GitWorz/logic-noise-synth/bom/Composants_tinkercad.csv

Nom | Quantité | Composant
U1 | 1 | Arduino Uno R3
Board 1 | 1 | Platine d'expérimentation
Board 2 | 1 | Petite platine d'expérimentation
C2 | 1 | 33uF, 50V Condensateur polarisé
D1, D2, D7, D8, D10, D11 | 6 | Jaune LED
Rpot2, Rpot3, Rpot4, Rpot5 | 4 | Potentiomètre
C3, C6, C7 | 3 | Condensateur polarisé
U3 | 1 | Schmitt d'inversion
D3, D4 | 2 | Rouge LED
D5 | 1 | Vert LED
D6, D9 | 2 | Bleu LED
U4 | 1 | Registre de décalage 8 bits
U2 | 1 | Amplificateur opérationnel 741
C4, C5 | 2 | Condensateur polarisé
PIEZO1 | 1 | Buzzer piézoélectrique
R1, R2, R3 | 3 | 1 kΩ Résistance
