GitWorz/logic-noise-synth/media/tinkercad/tinkercad_schematic.pdf

A

1 | 2 | 3 | 4 | 5 | 6

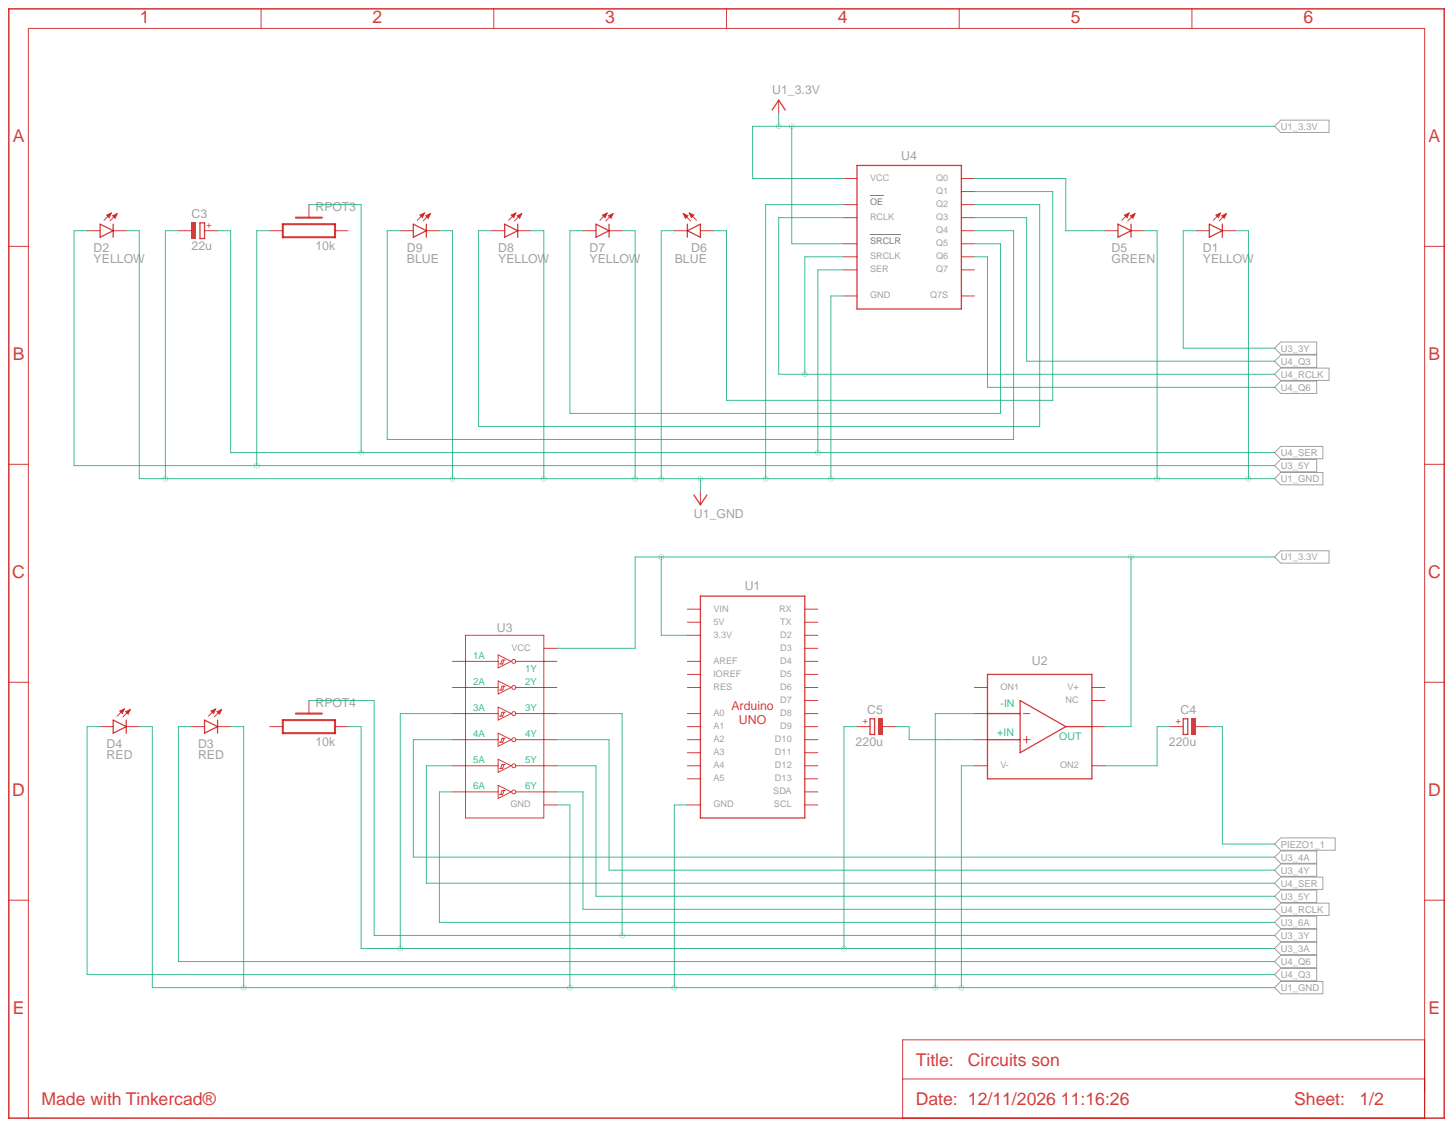
[picture p13: page 1]

A

1 | 2 | 3 | 4 | 5 | 6

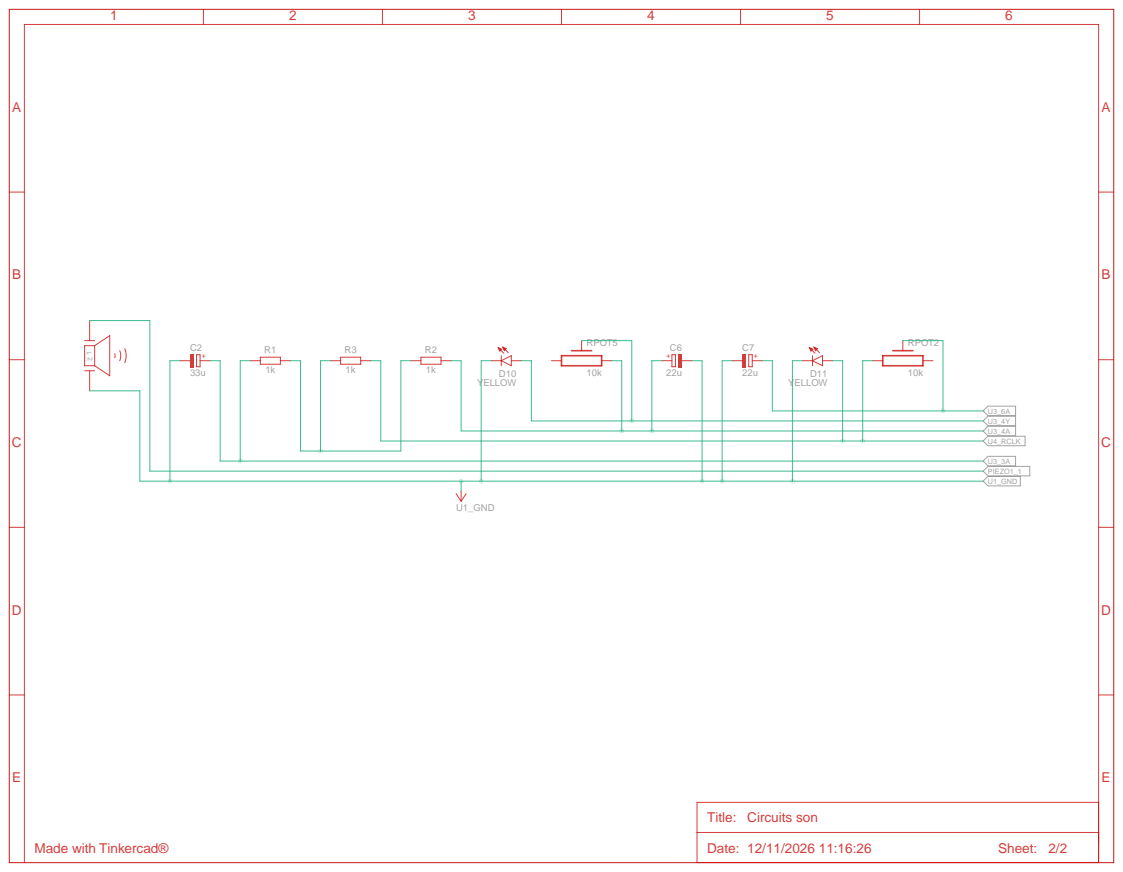
[picture p14: page 2]
