GitWorz/logic-noise-synth/docs/BOOTCAMP_WORKSHOP_2024.pdf

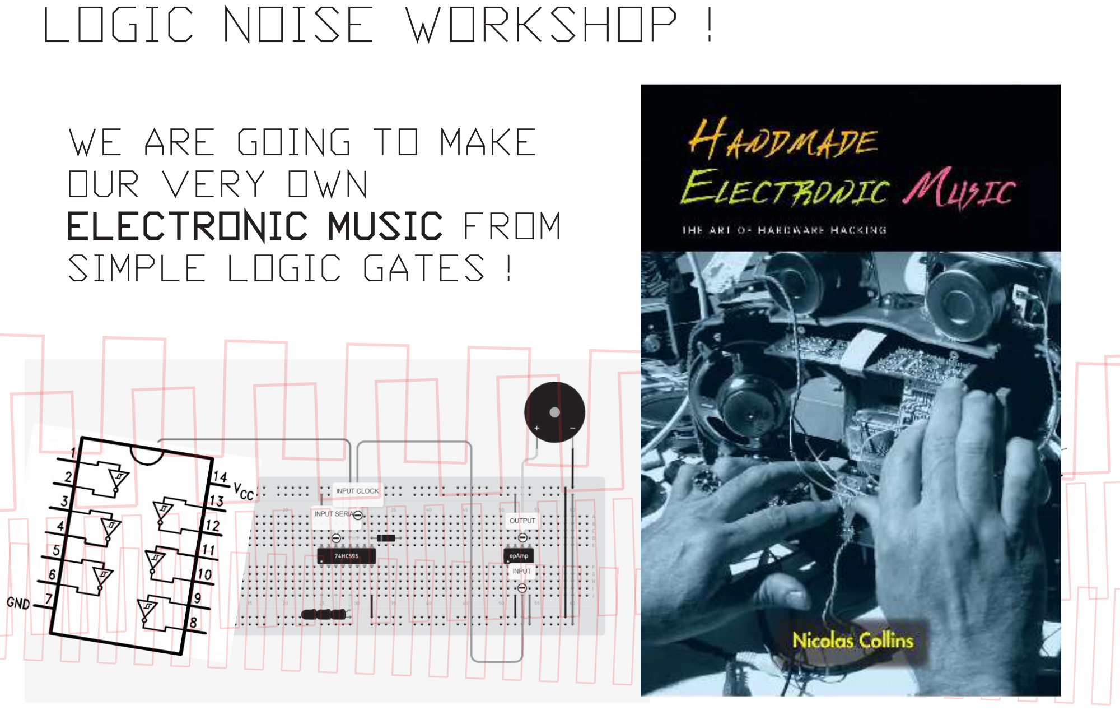
[picture p15: page 1]

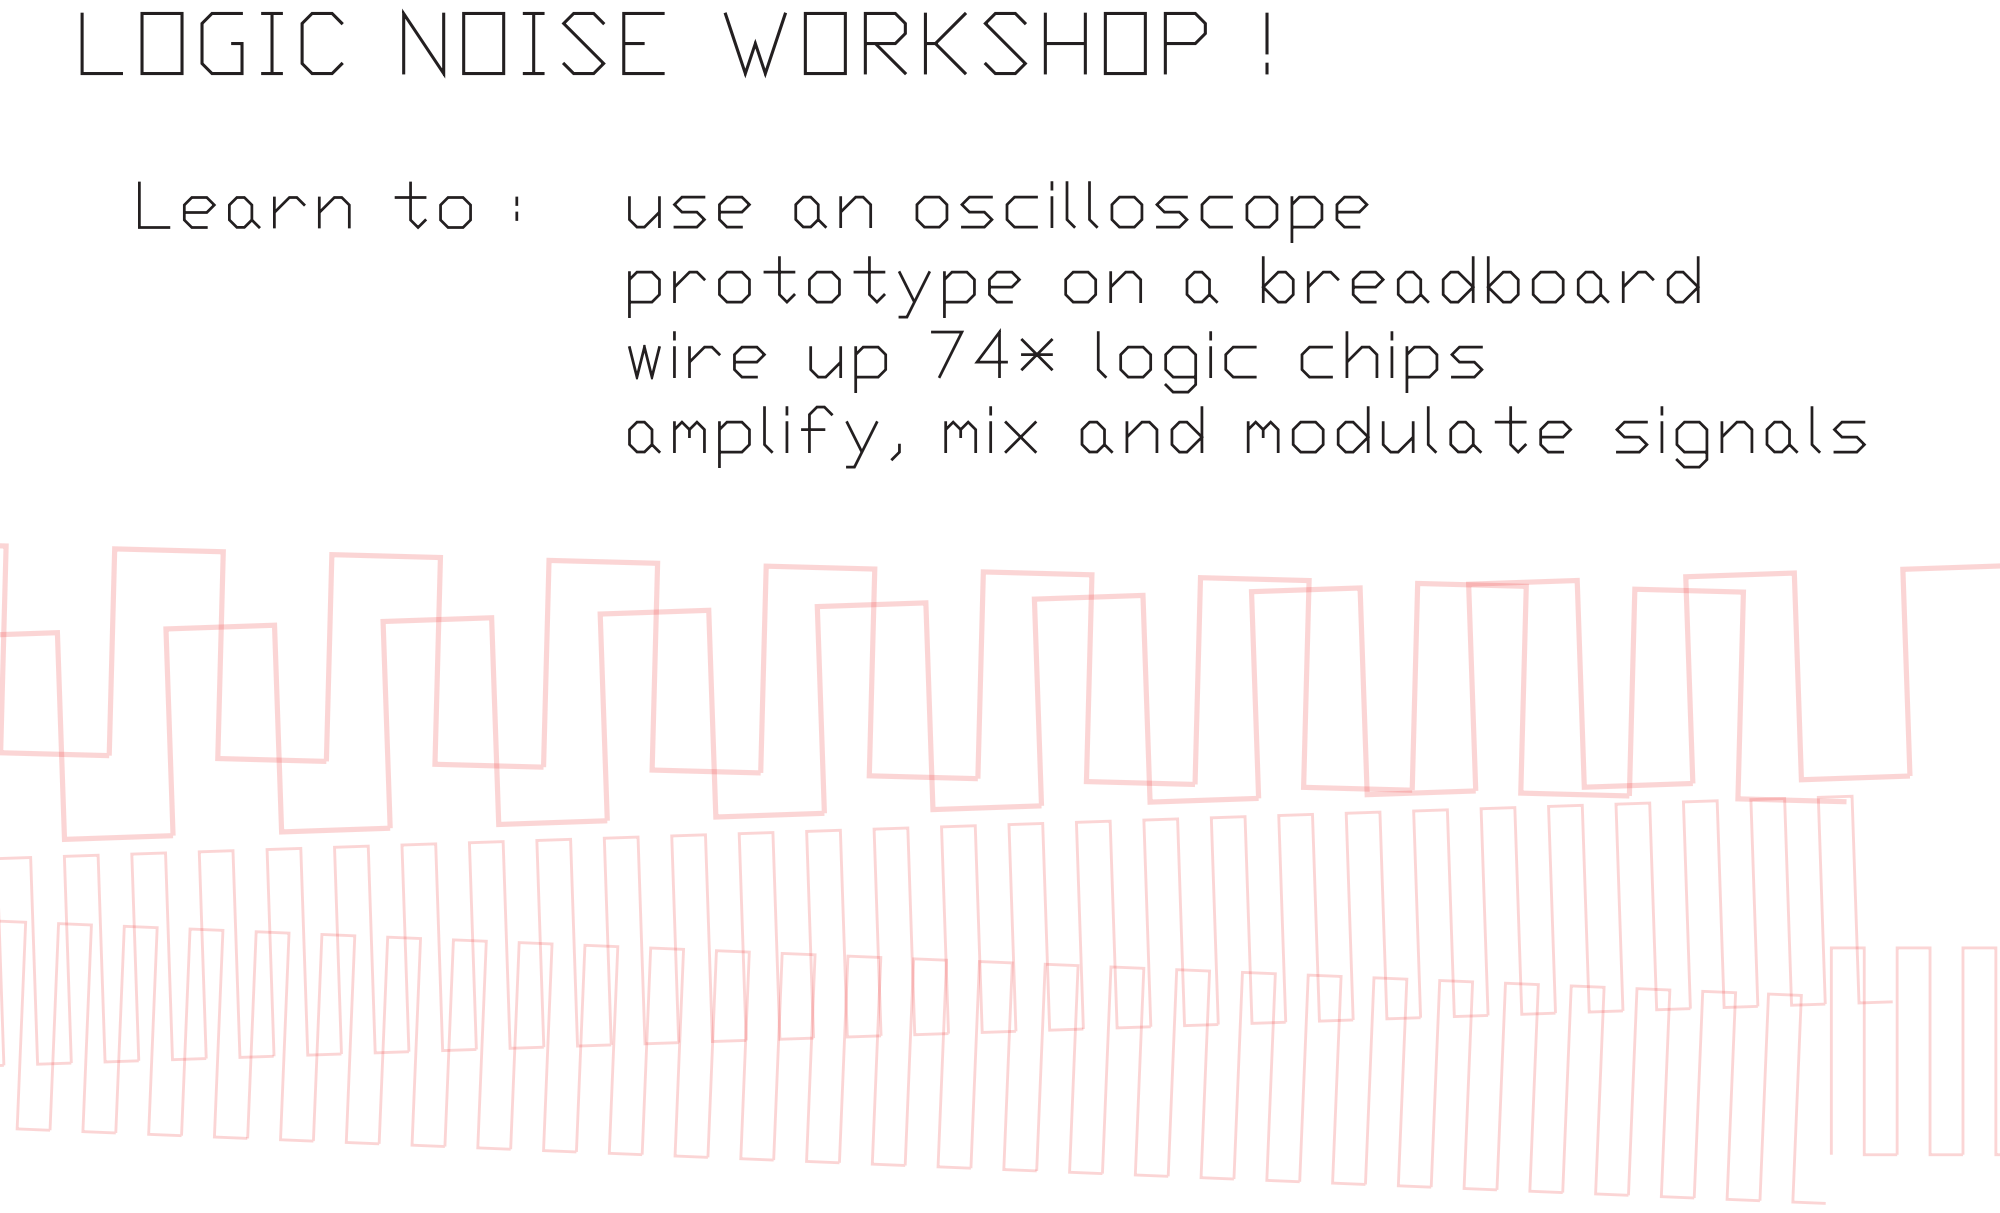
[picture p16: page 2]

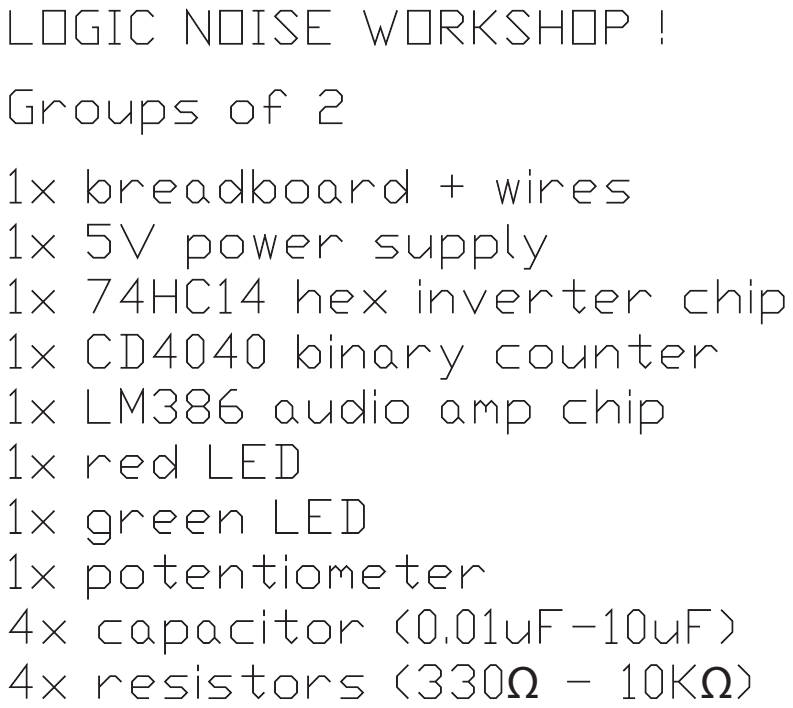
[picture p17: page 3]

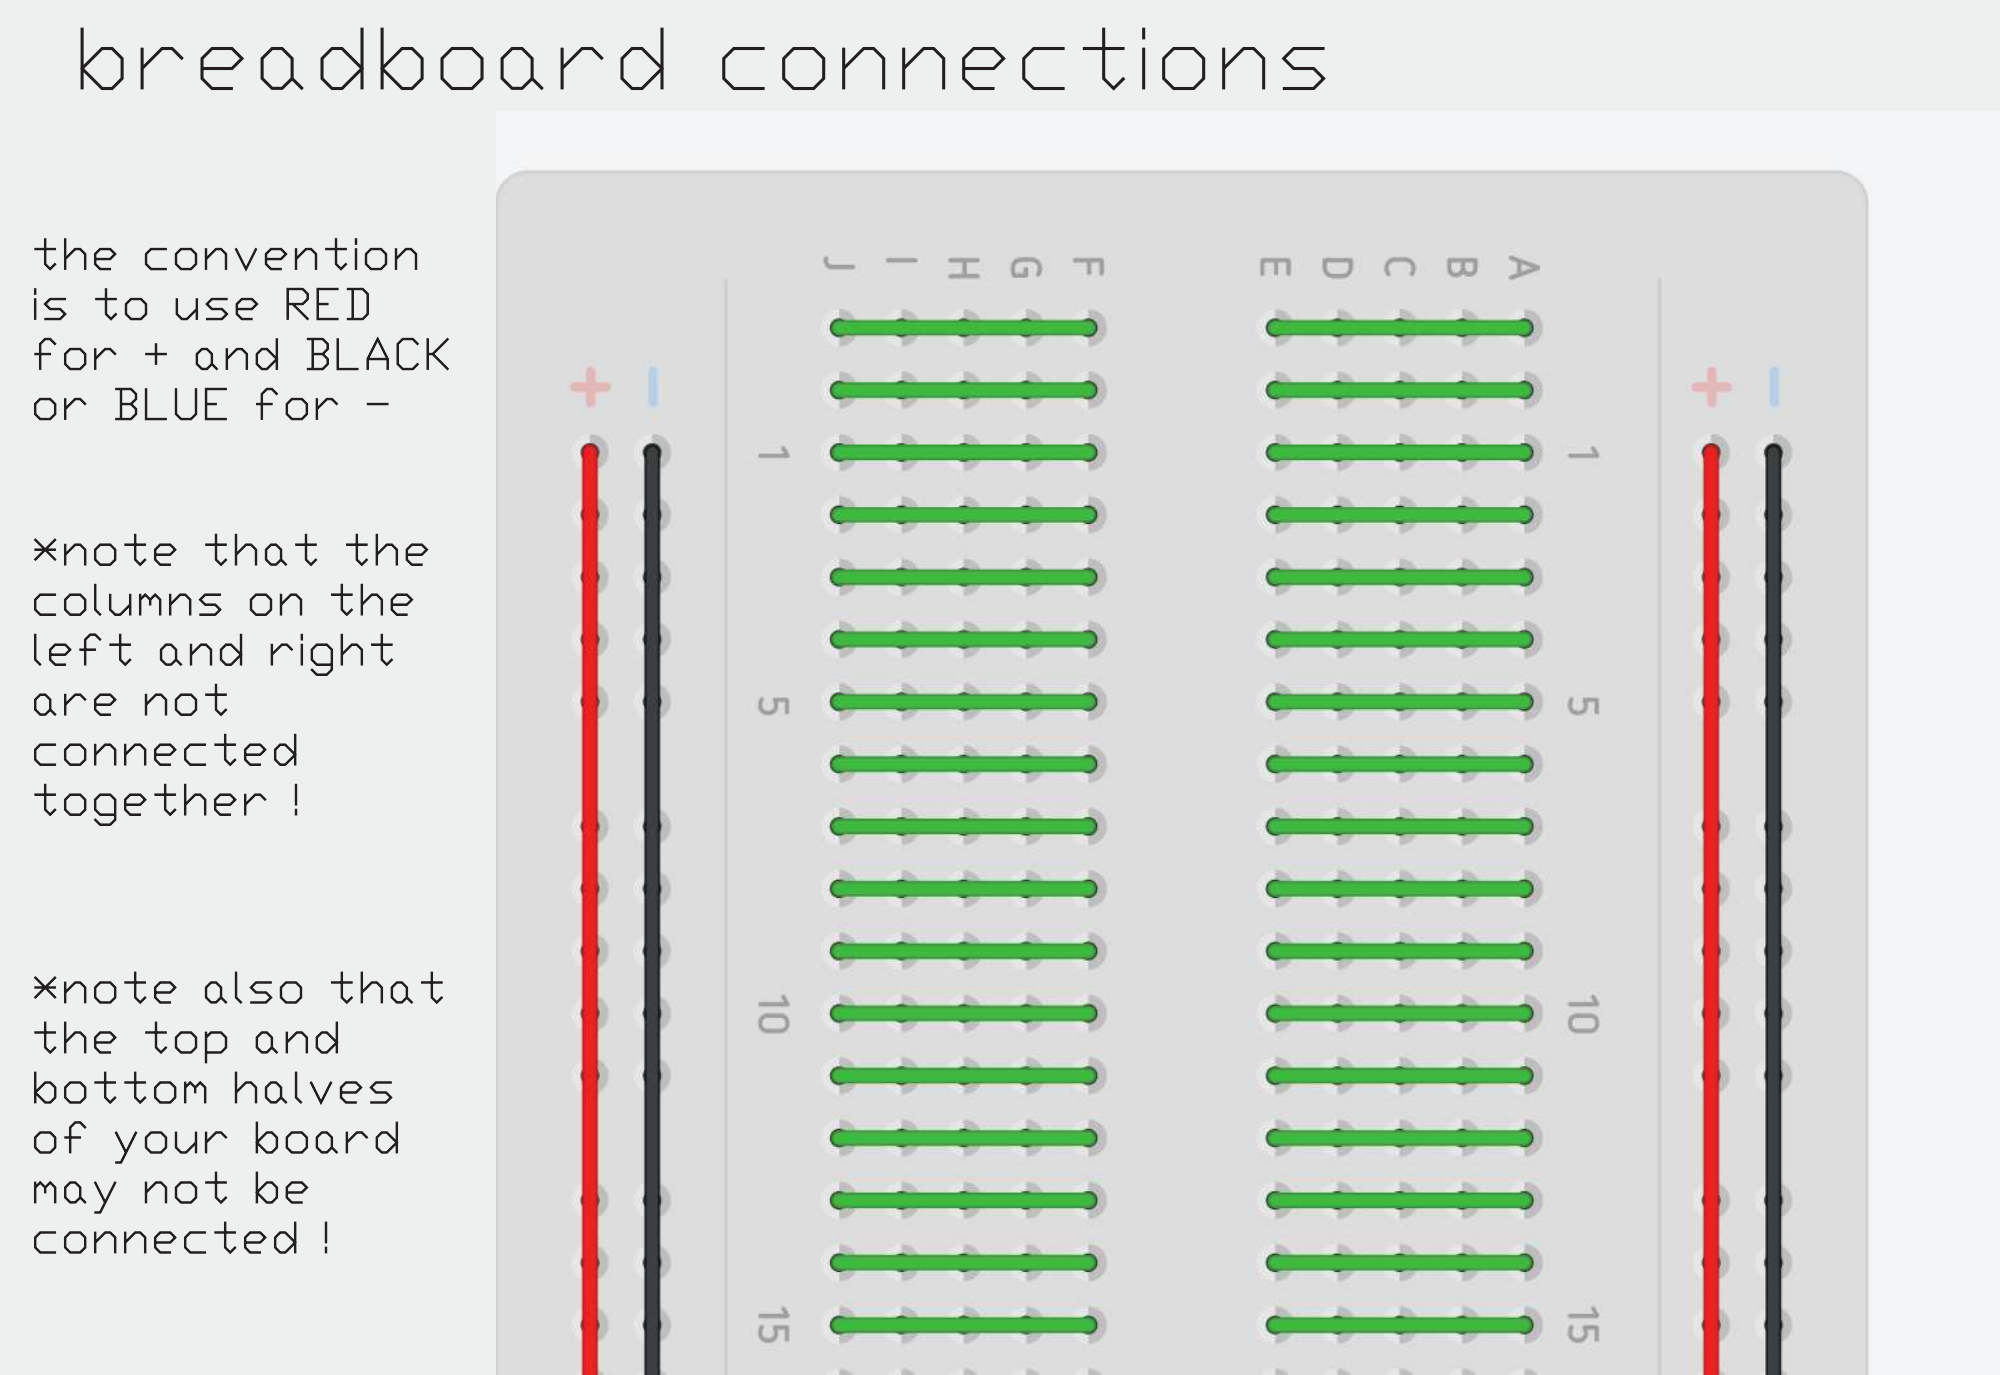
[picture p18: page 4]

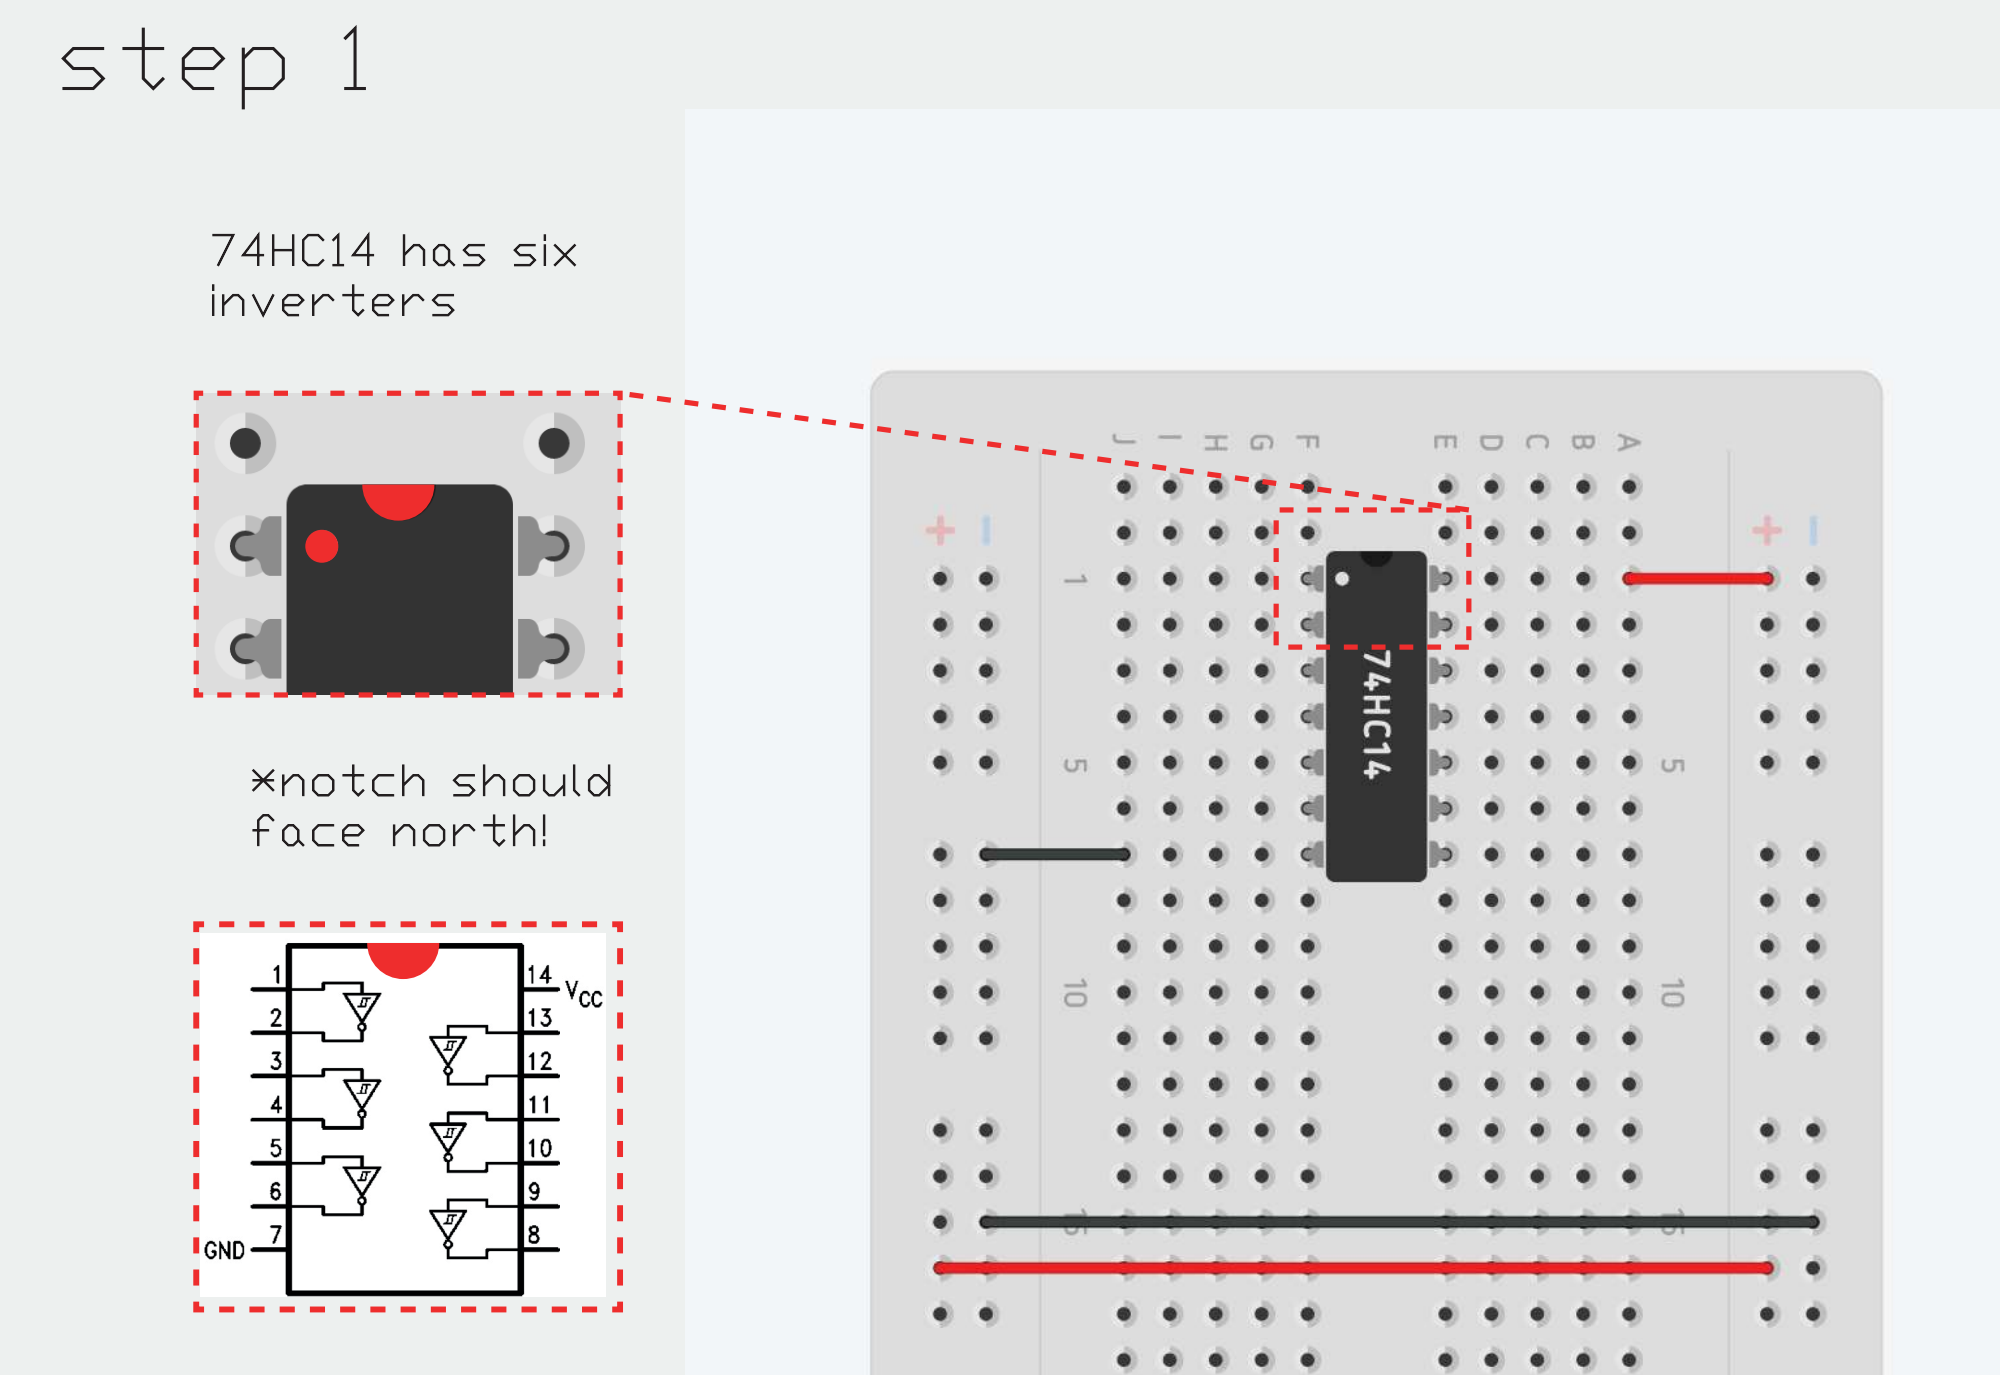
[picture p19: page 5]

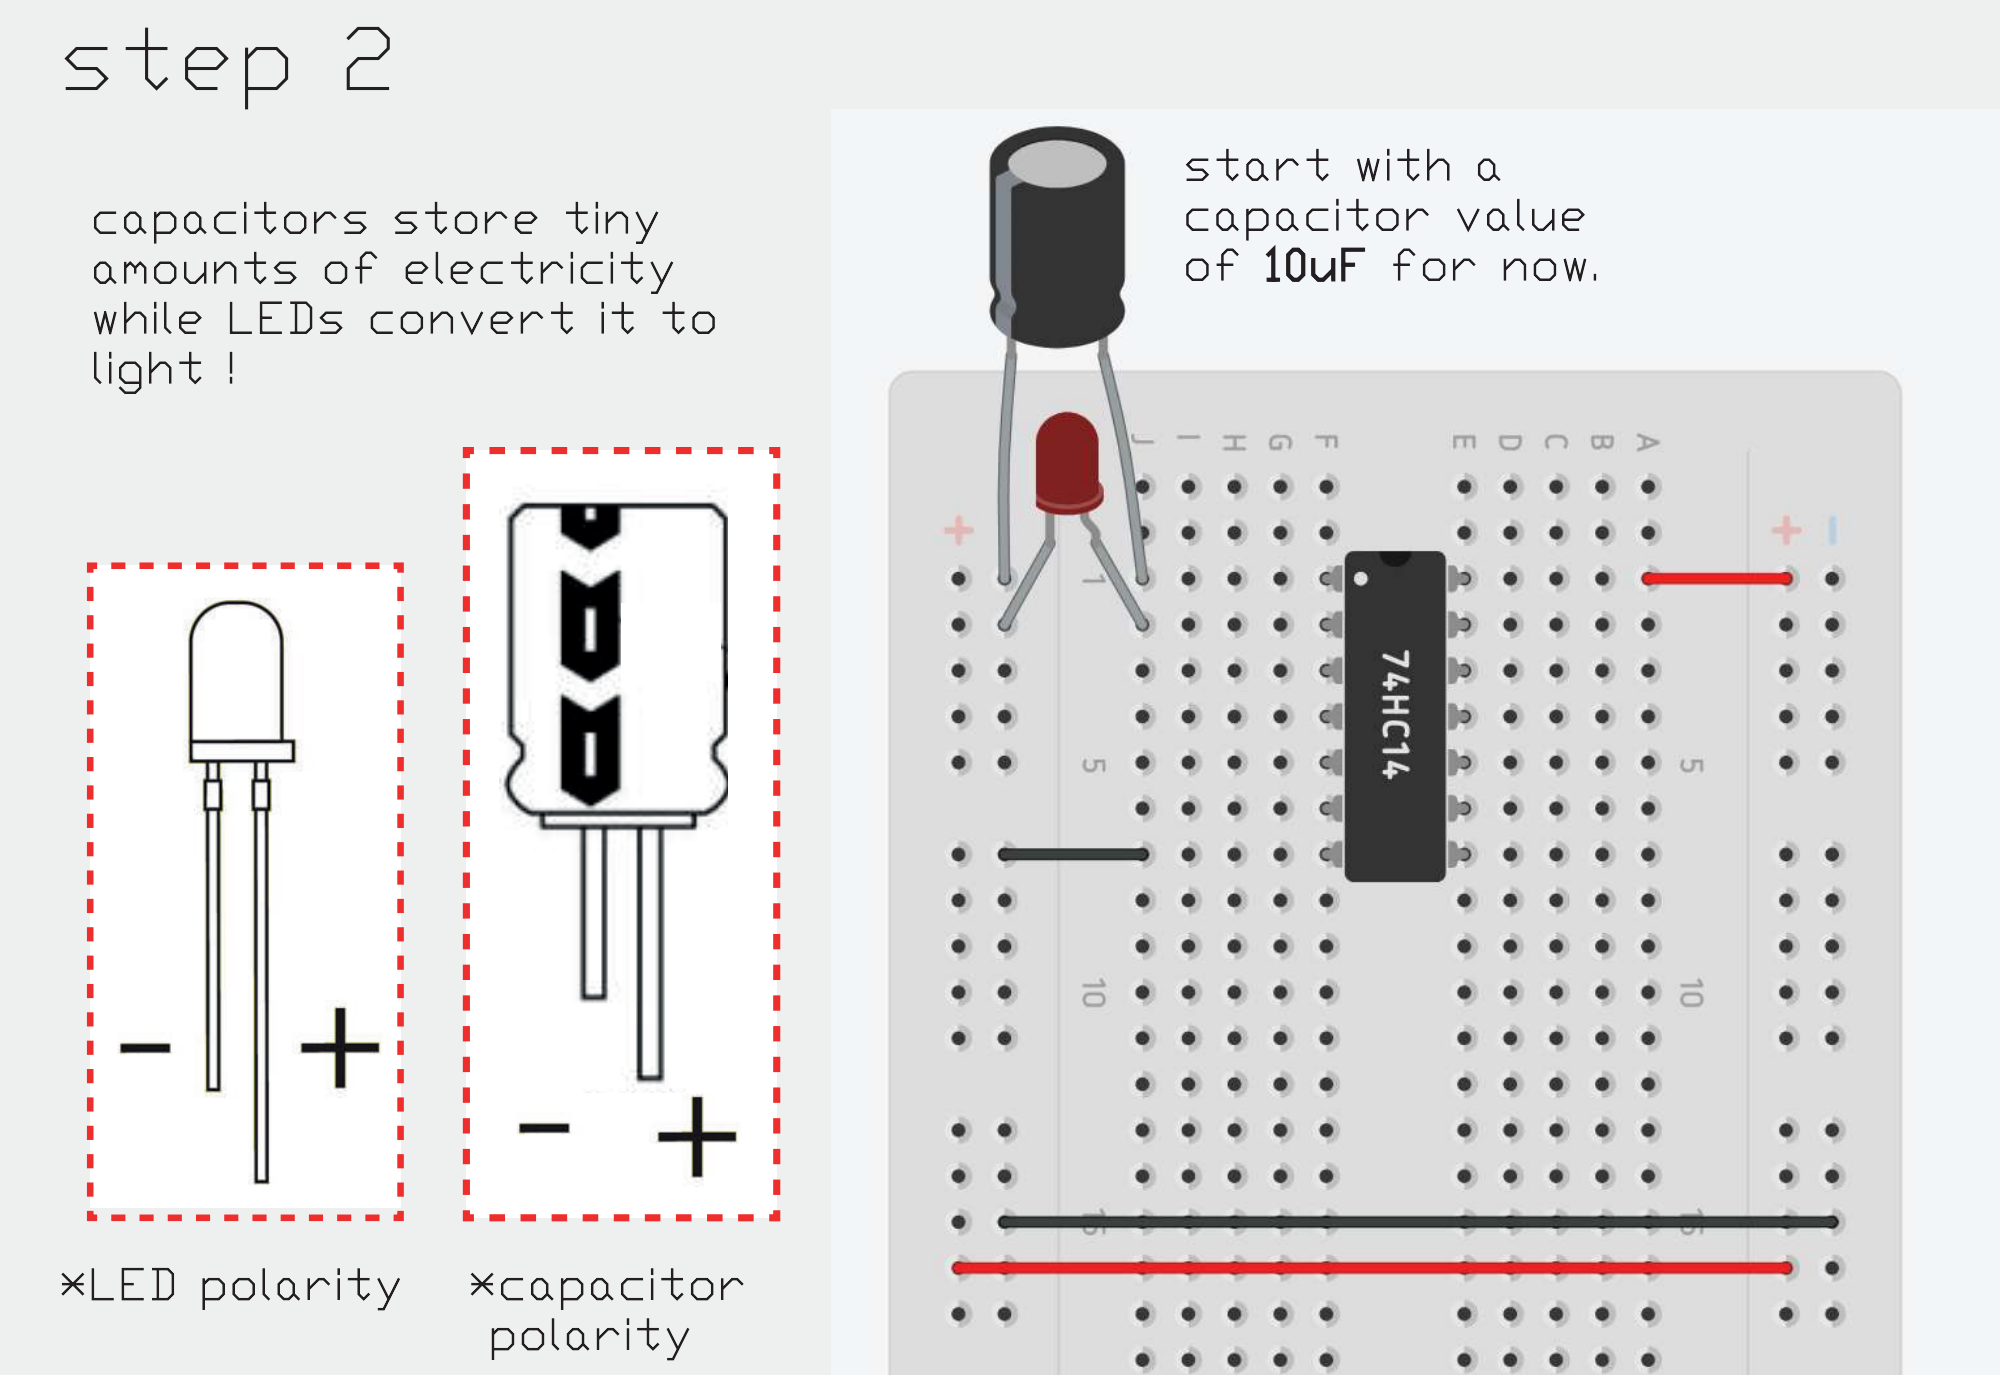
[picture p20: page 6]

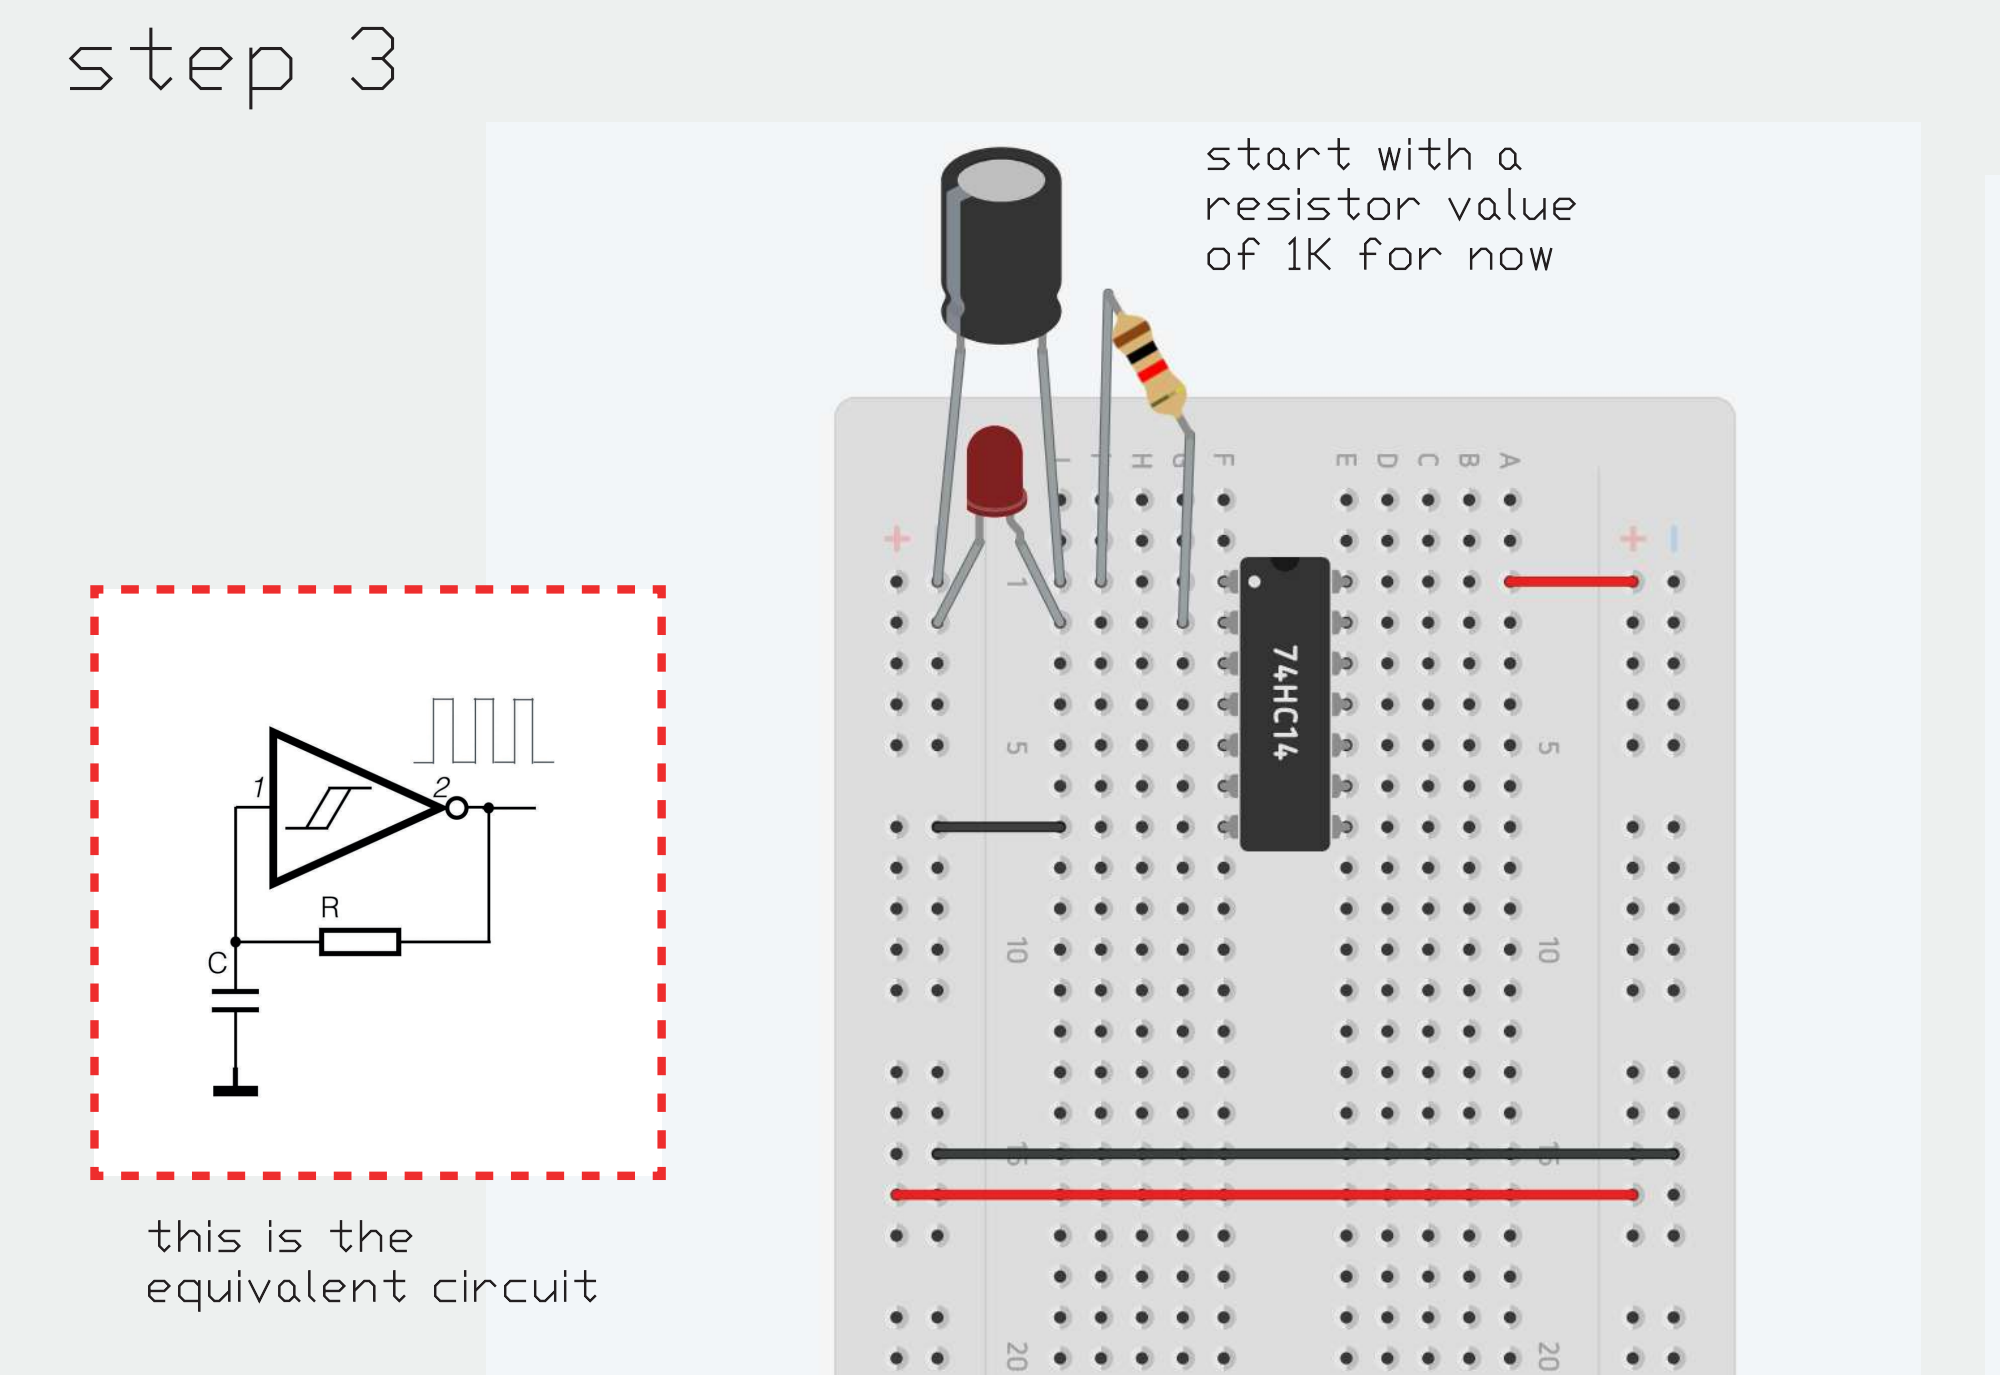
[picture p21: page 7]

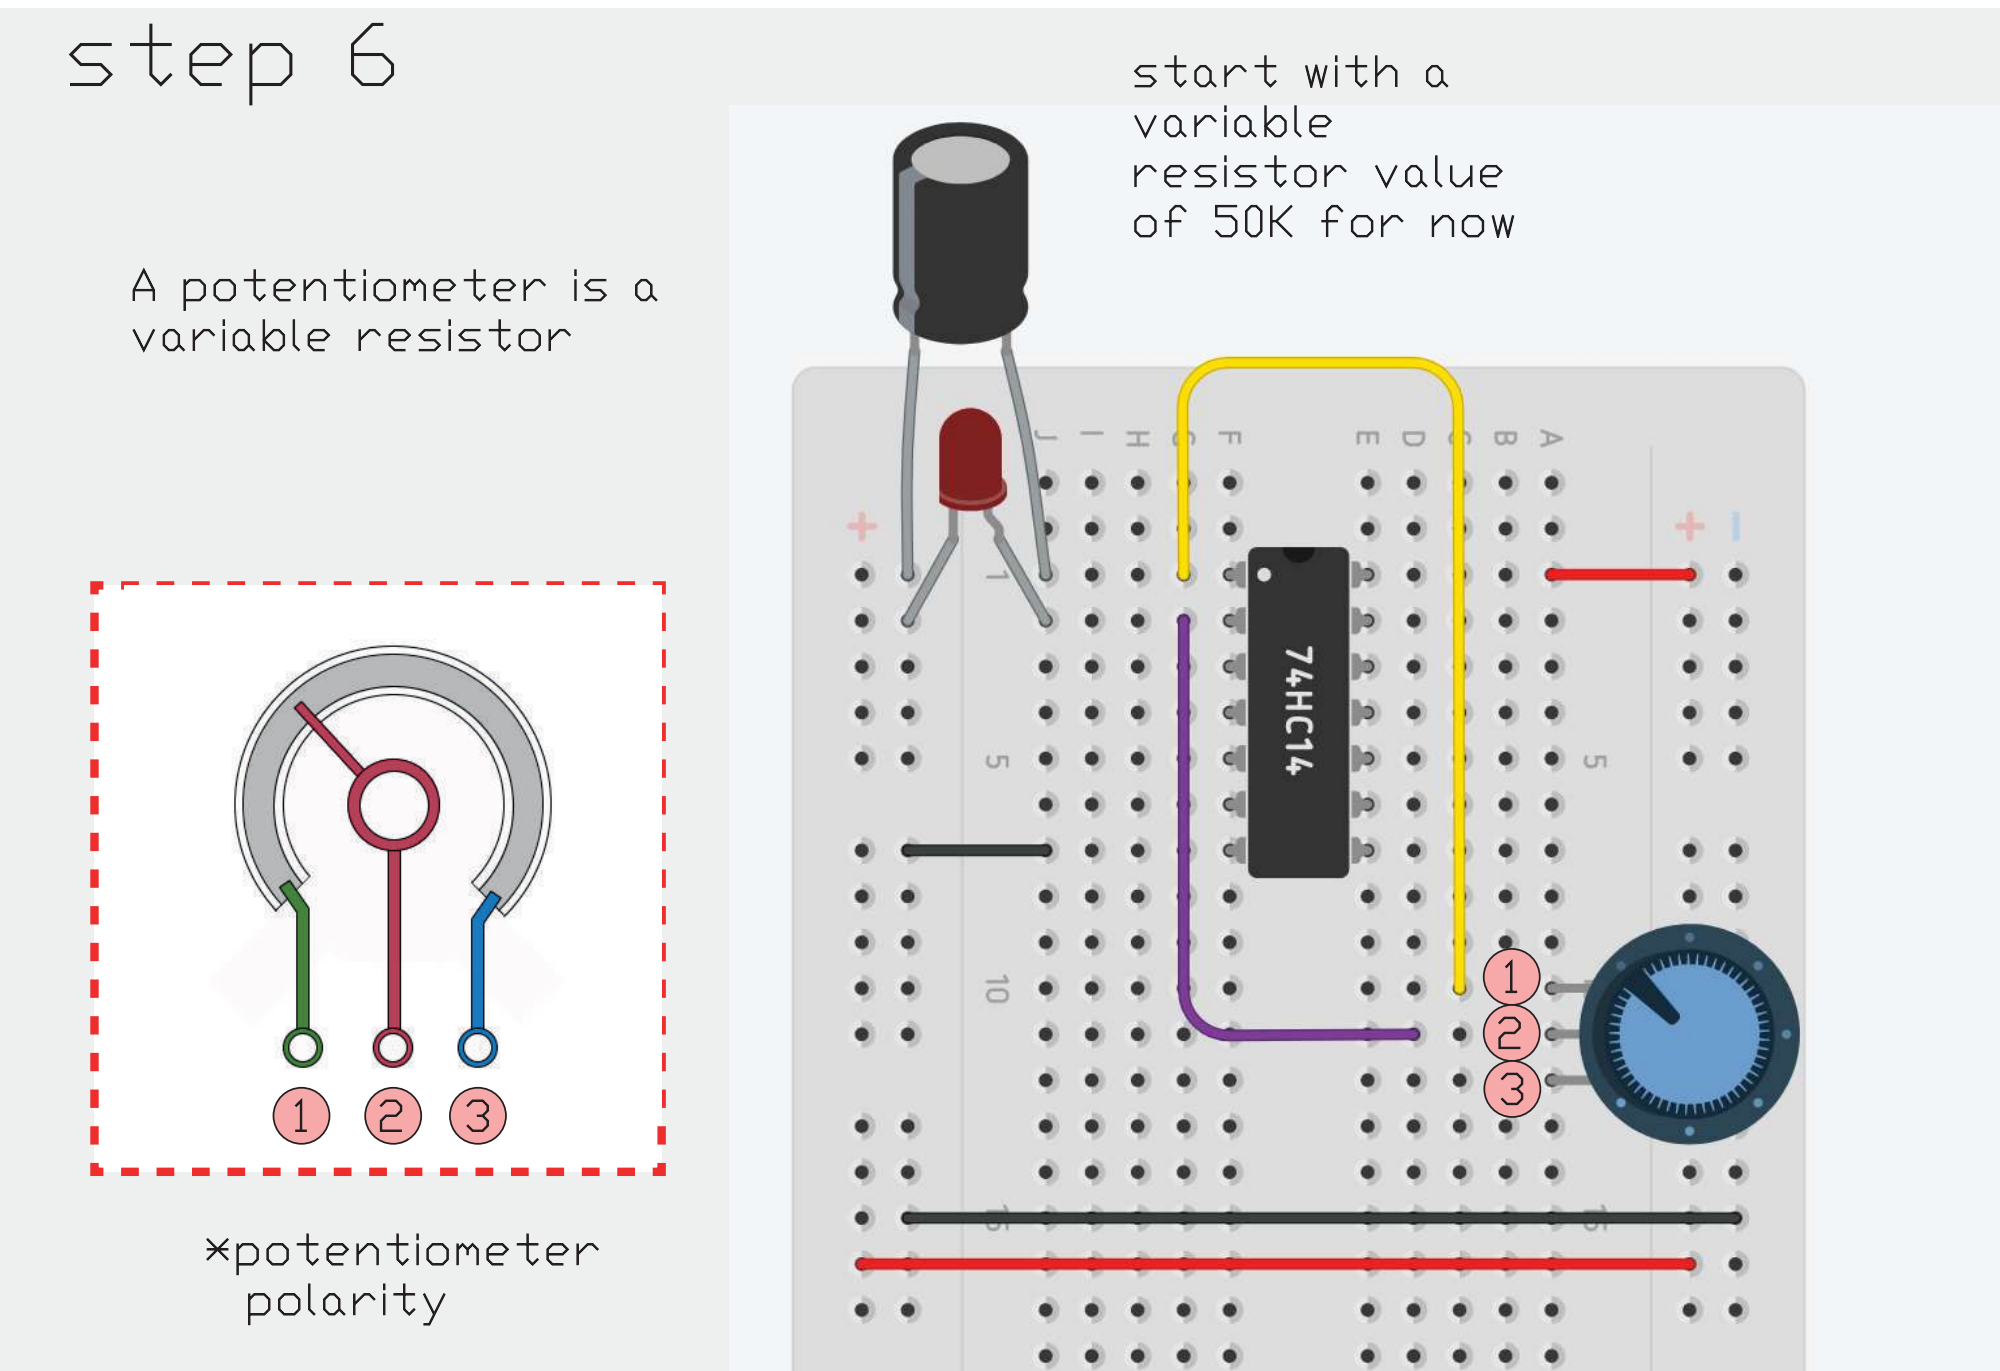
[picture p22: page 8]

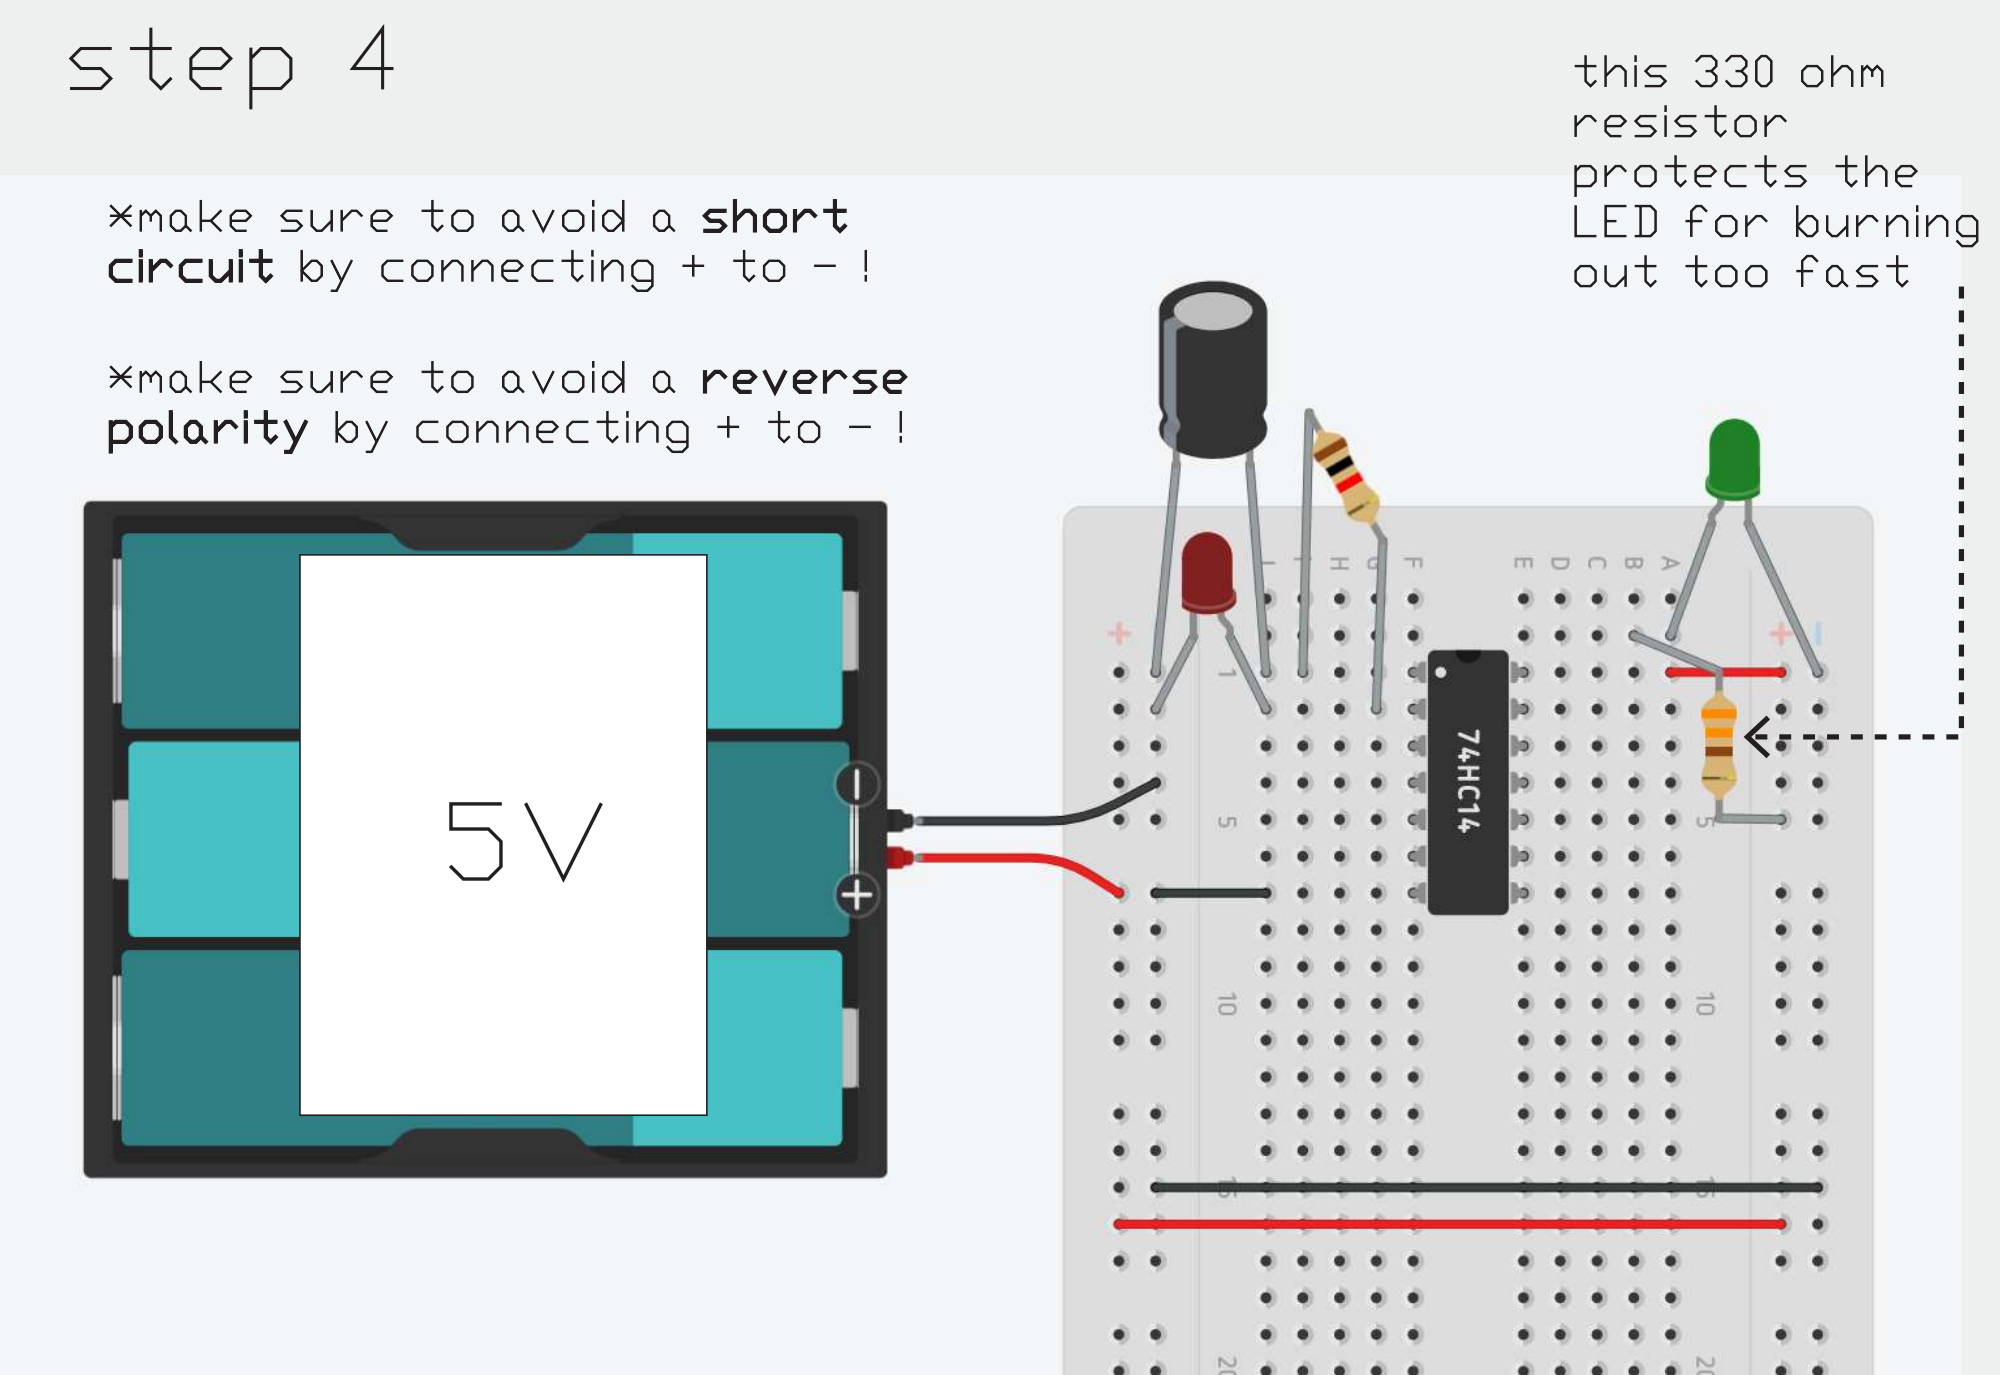
[picture p23: page 9]

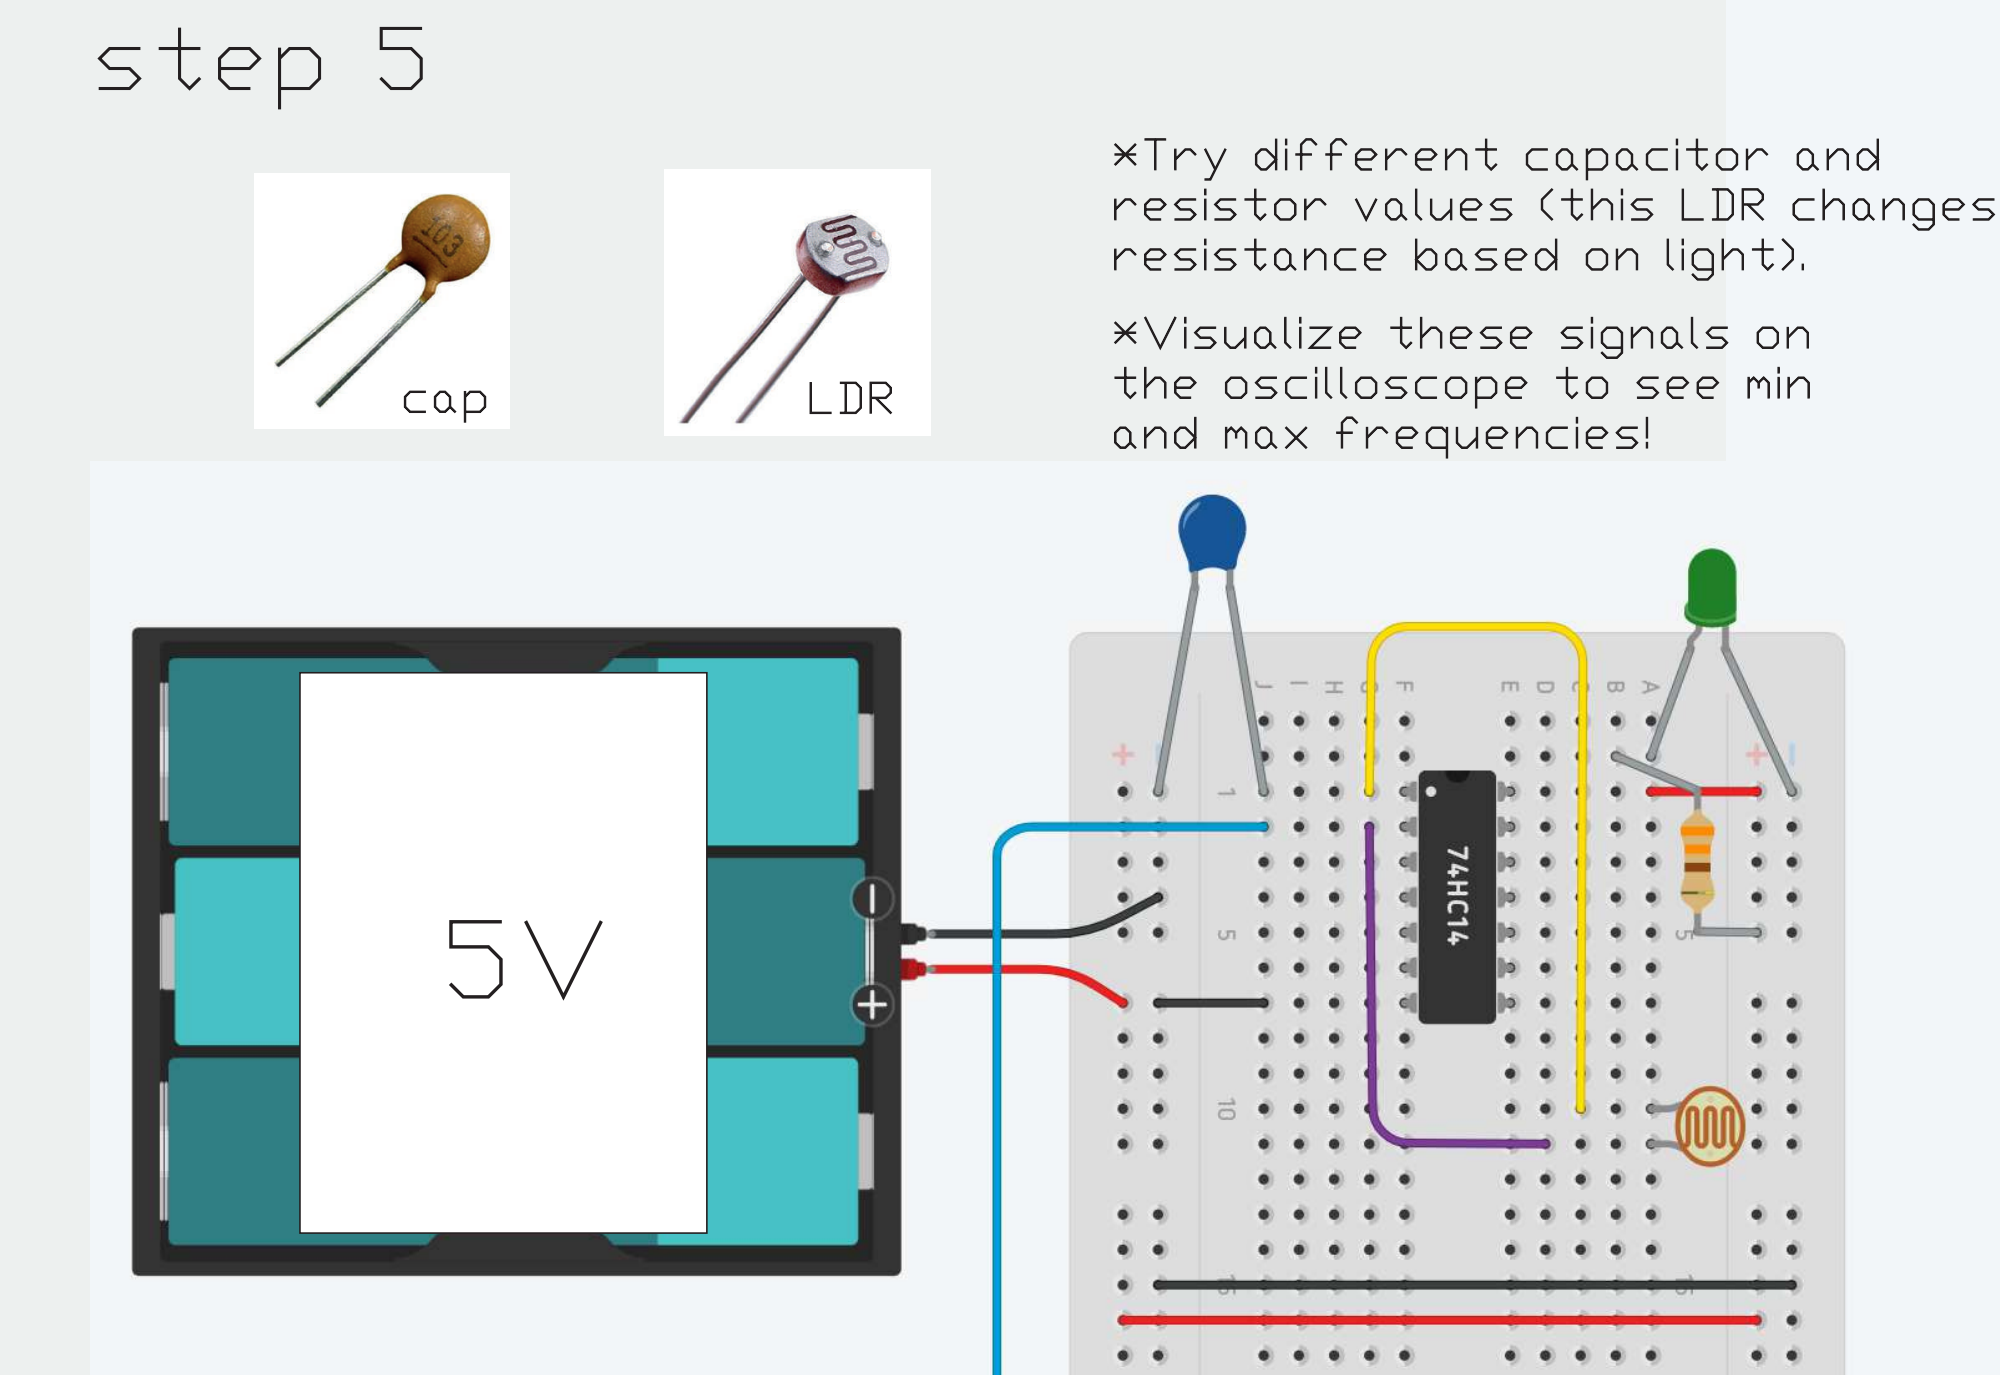
[picture p24: page 10]

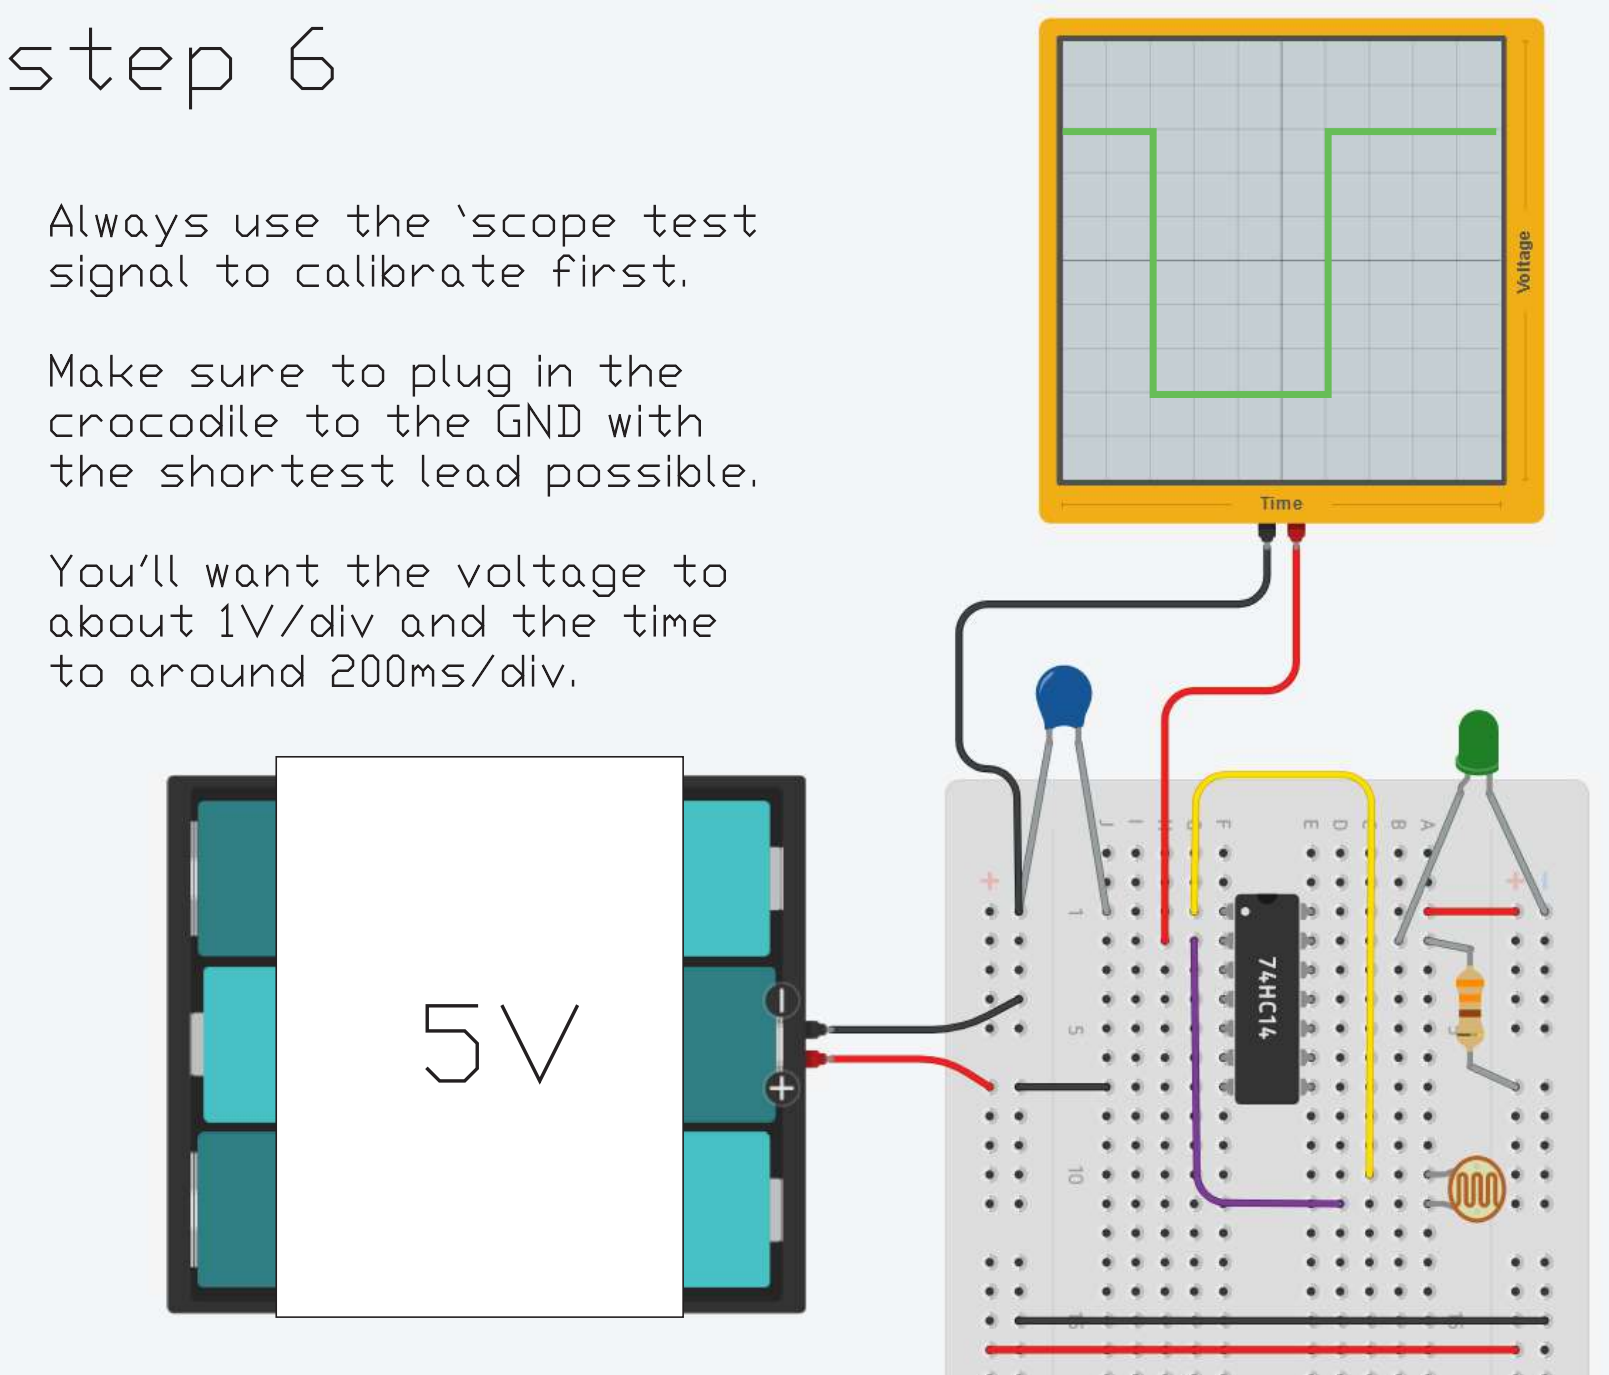
[picture p25: page 11]

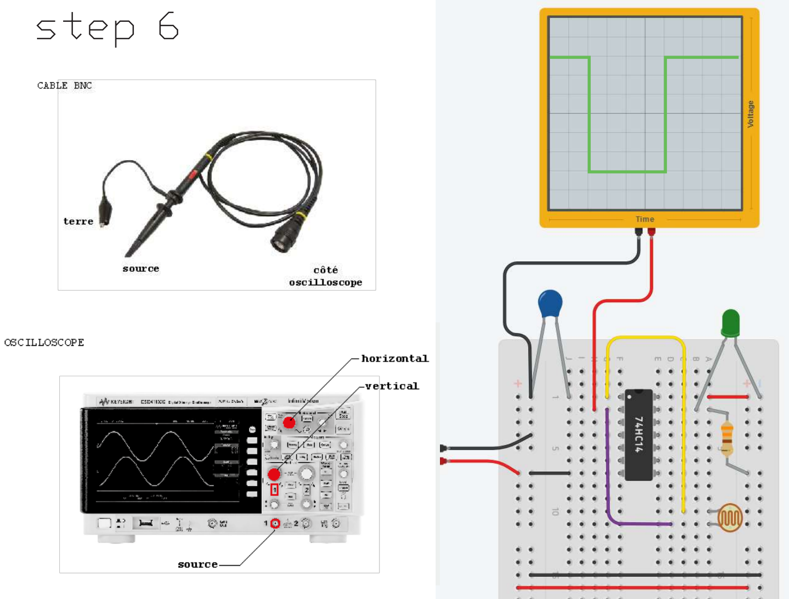
[picture p26: page 12]
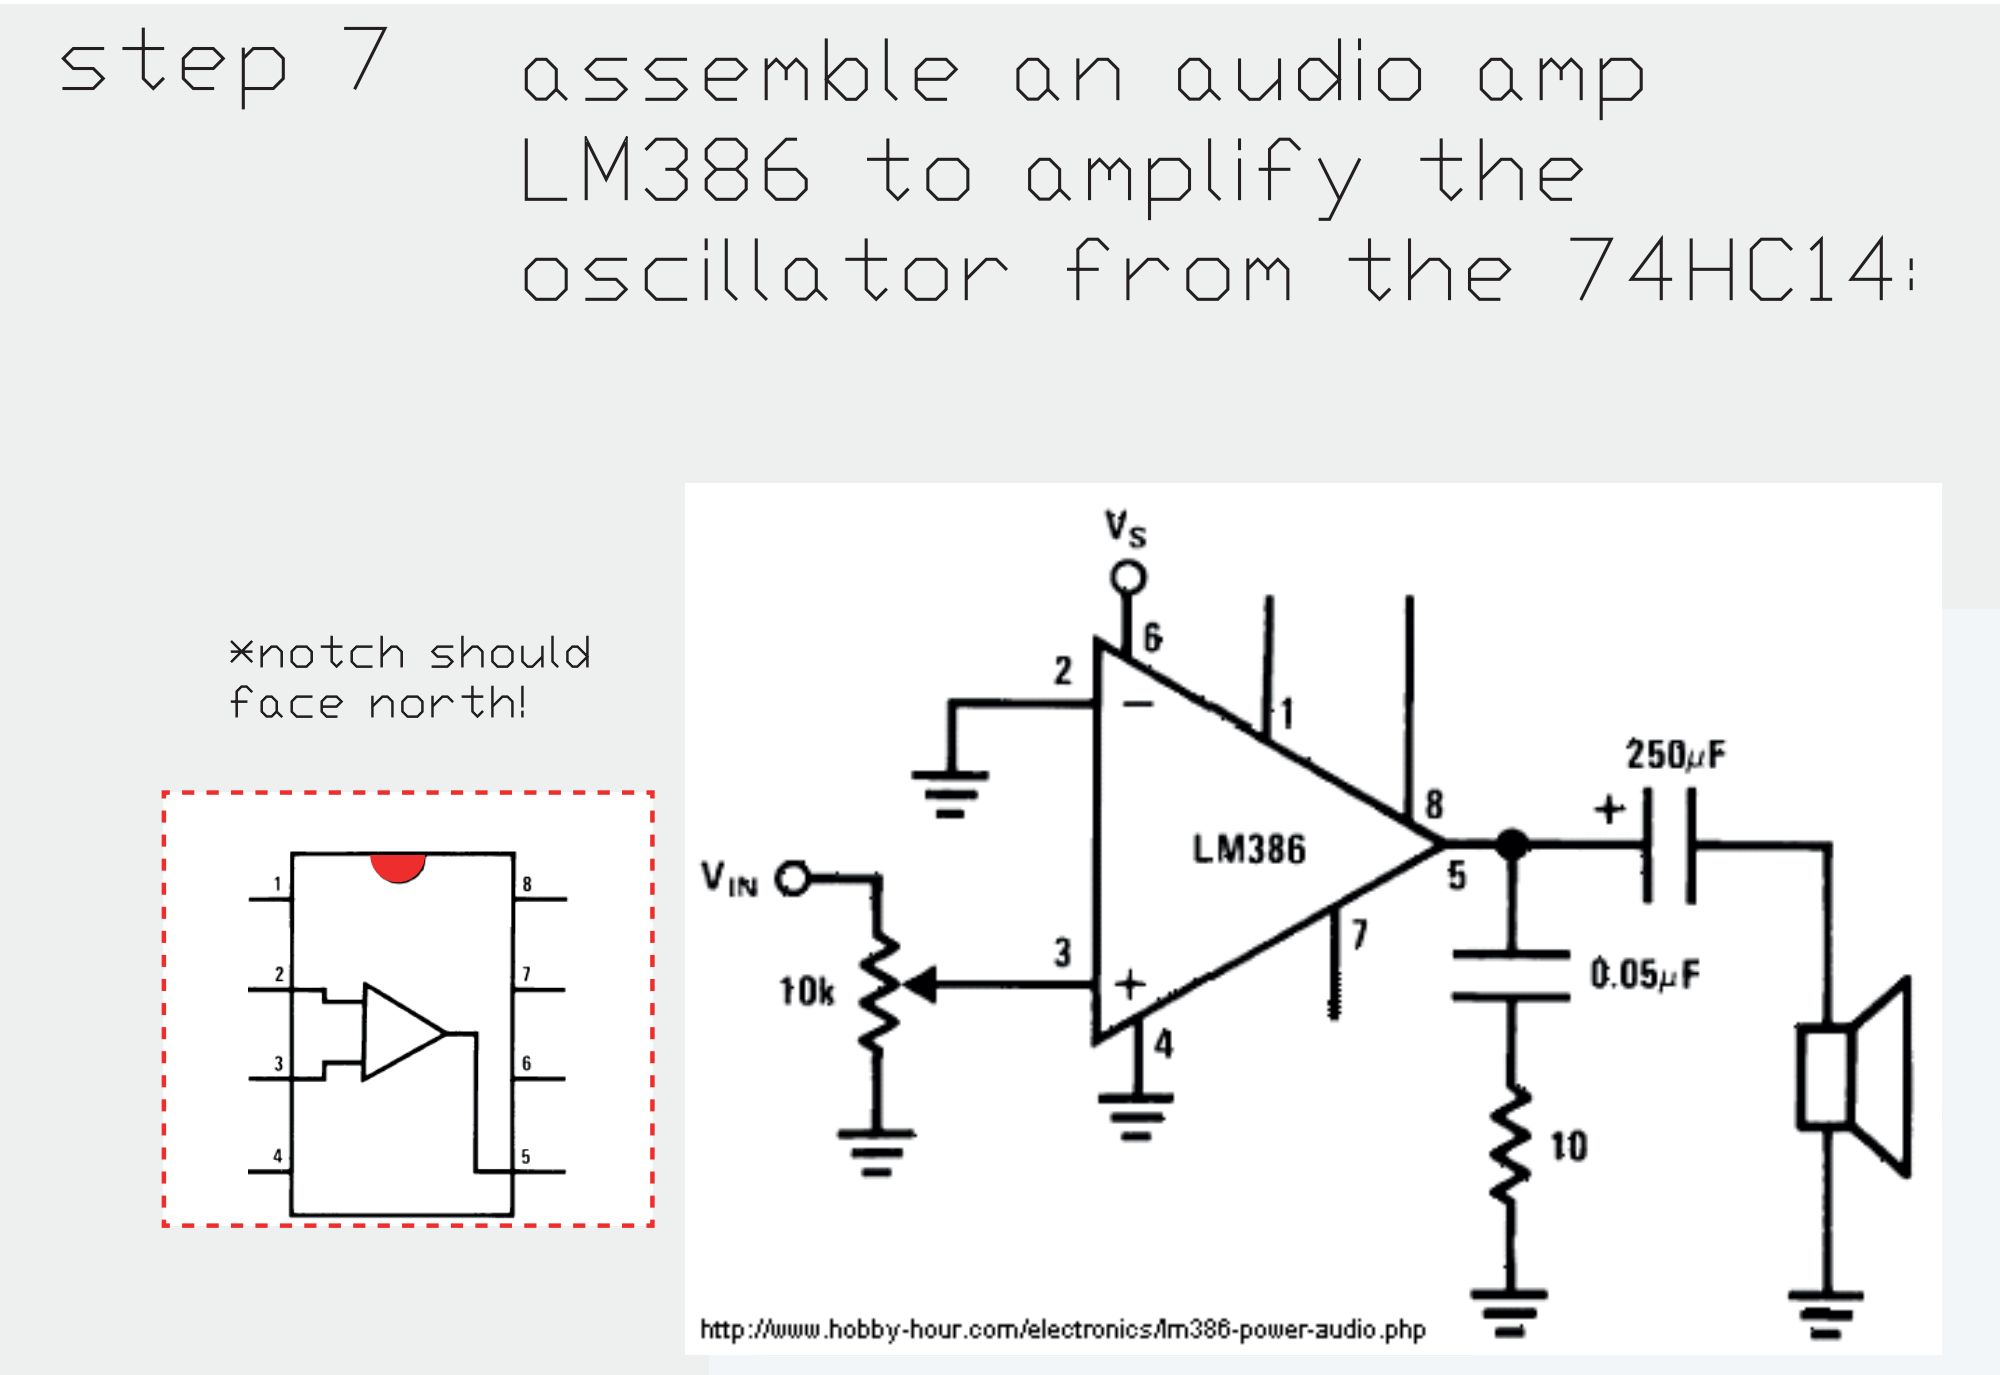
[picture p27: page 13]

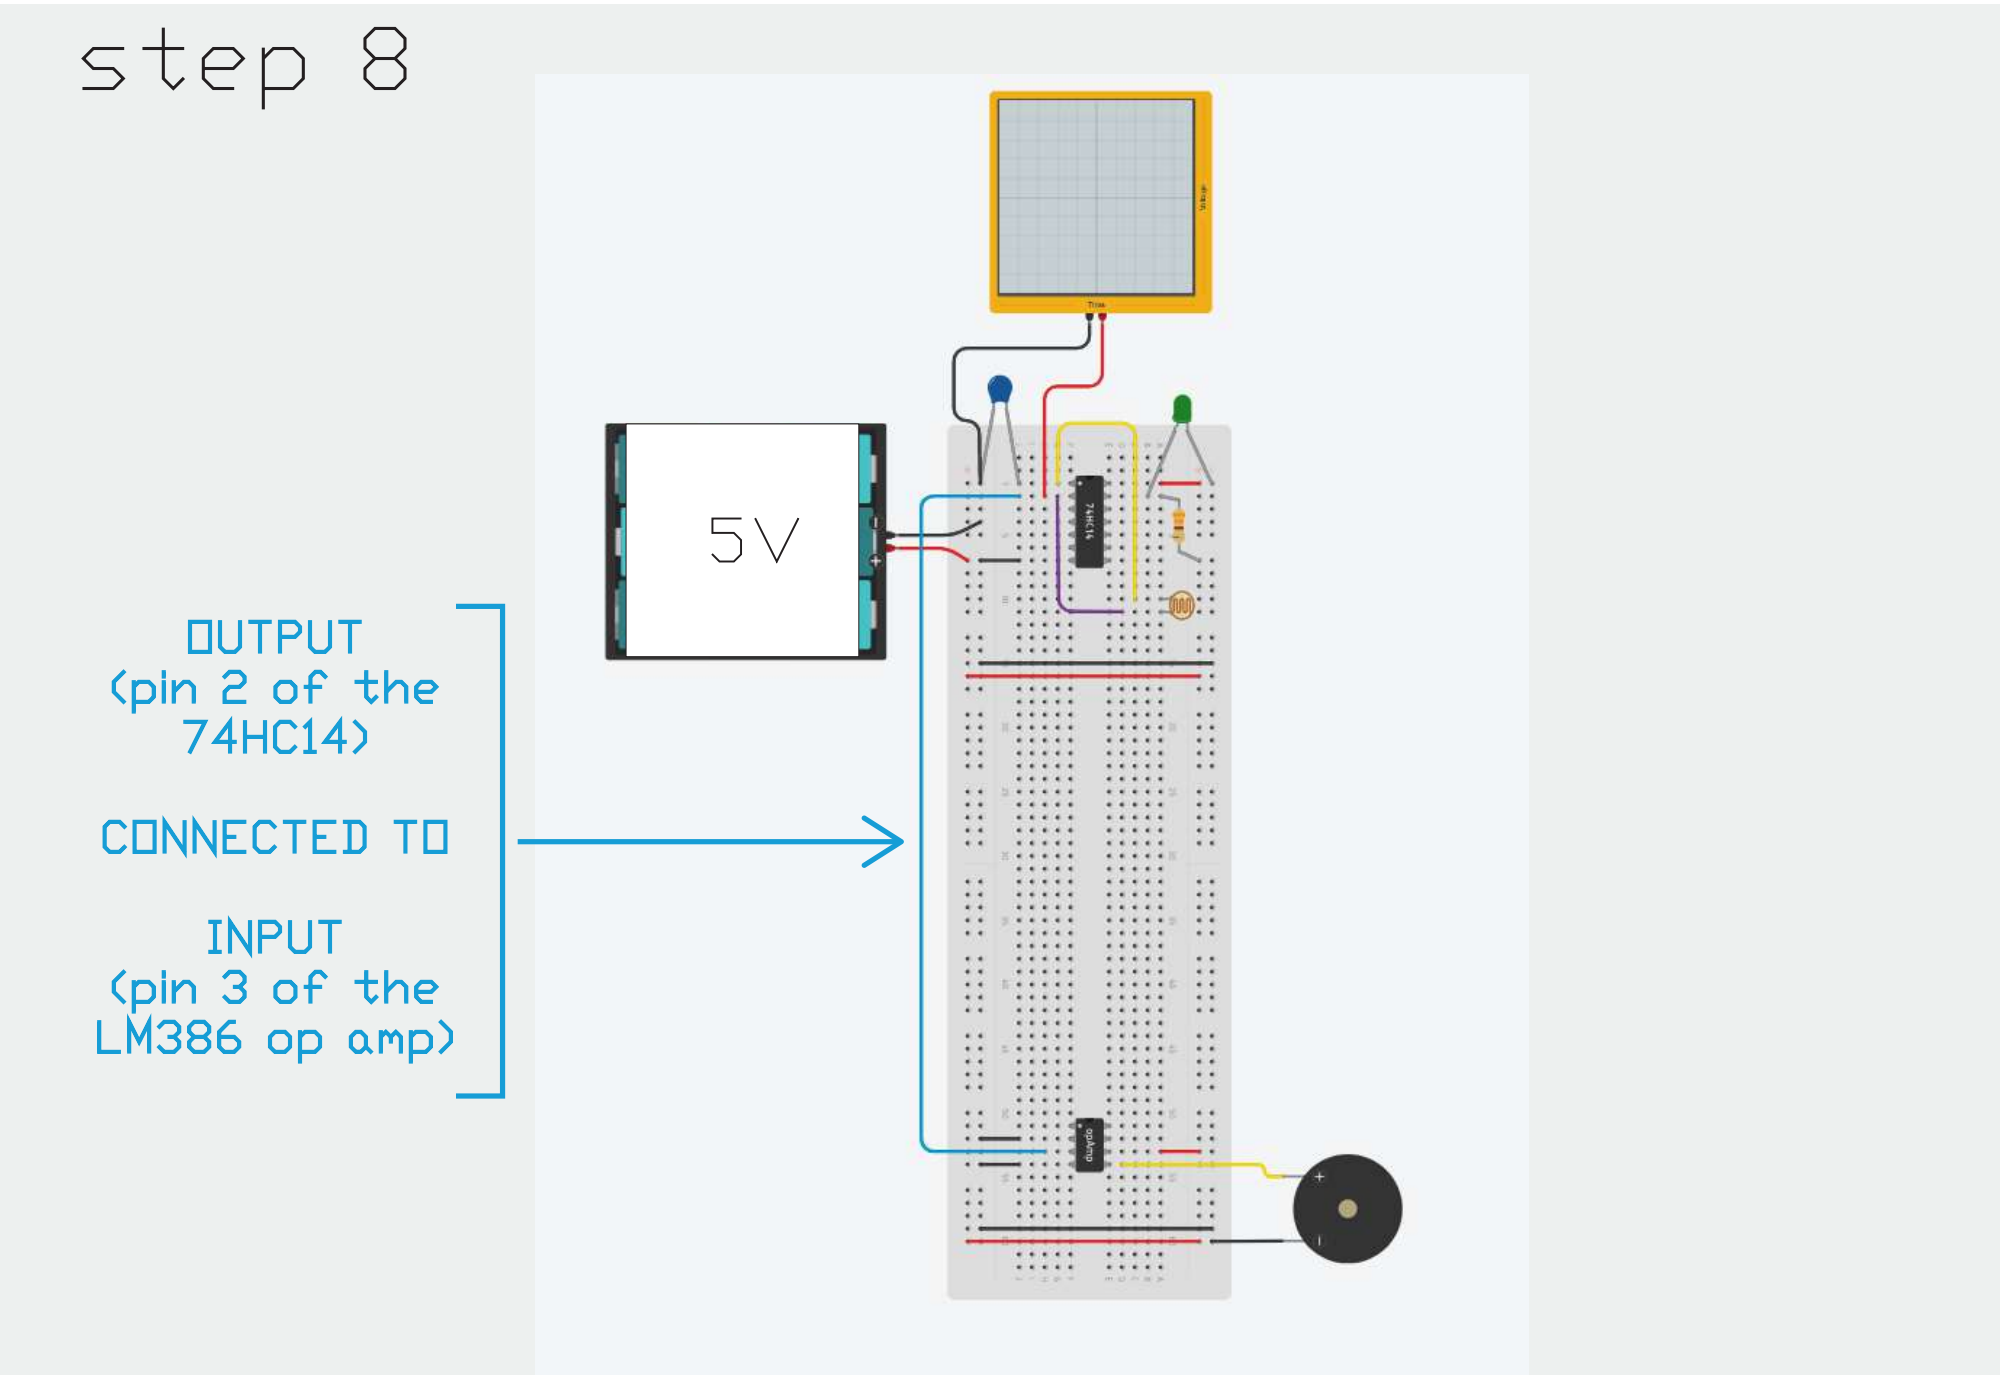
[picture p28: page 14]

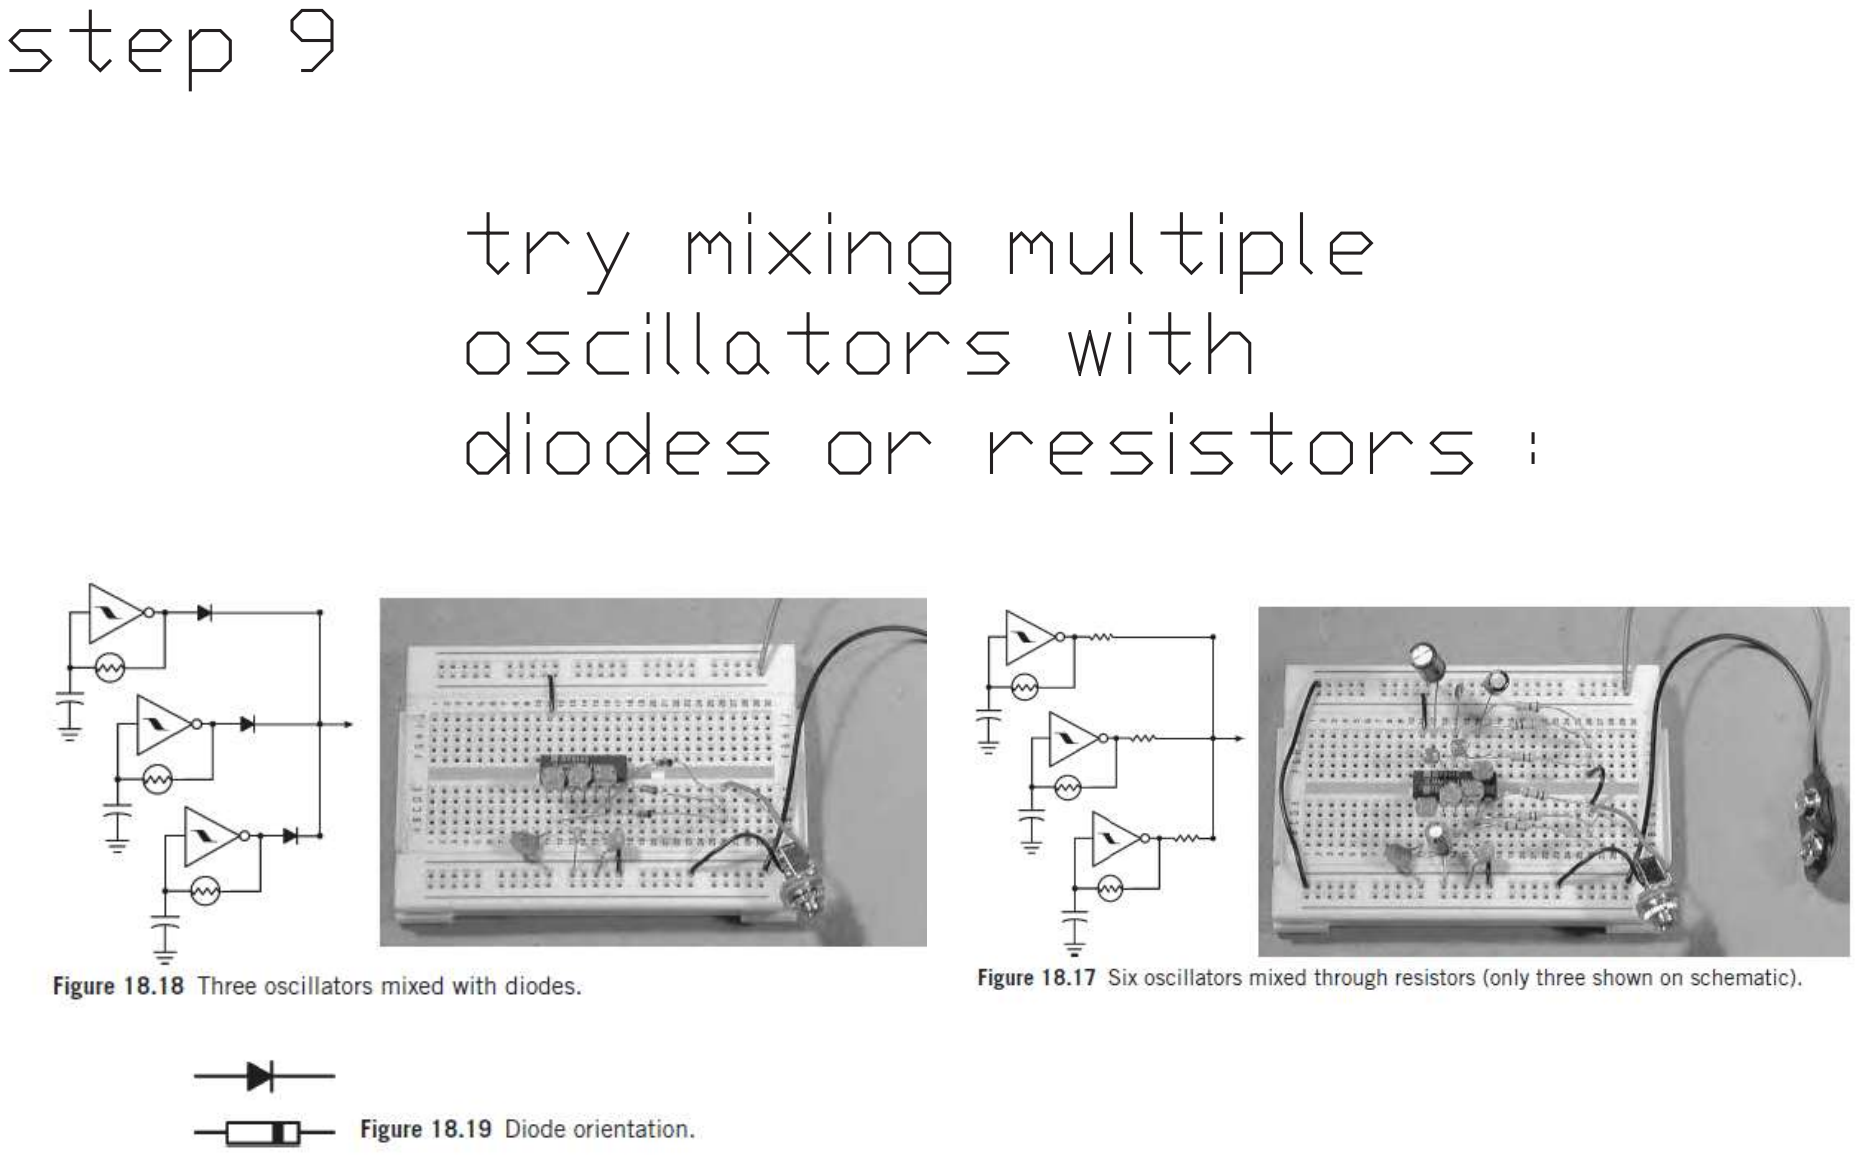
[picture p29: page 15]

# INVERTER

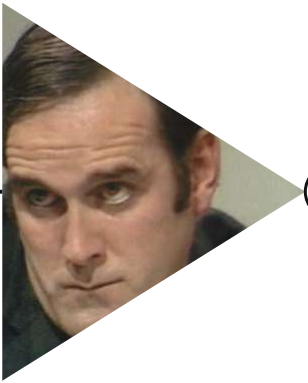
[picture p30: figure]

“YES,

# I DID!”

“NO,

# YOU DIDN’T”

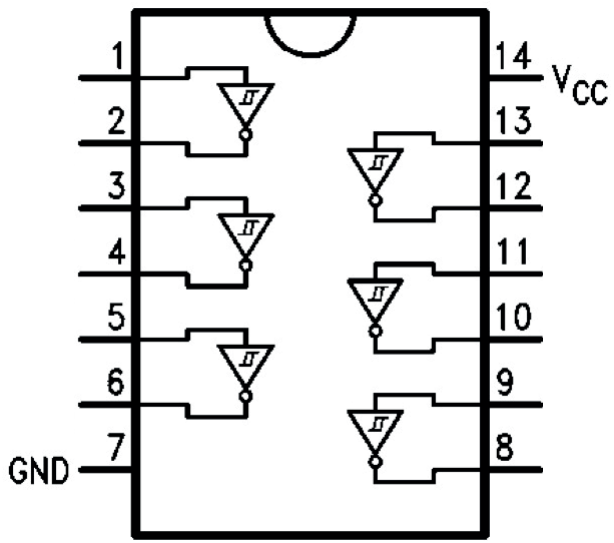
[picture p31: figure]

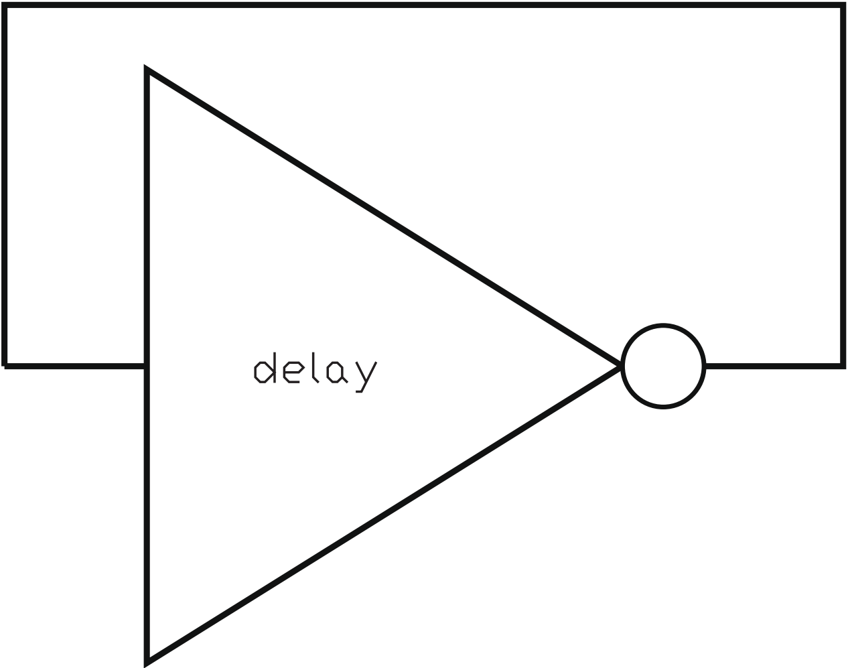
[picture p32: figure]

t = 0 | 1 | 2 | 3 | 4

# NO YES NO YESNO

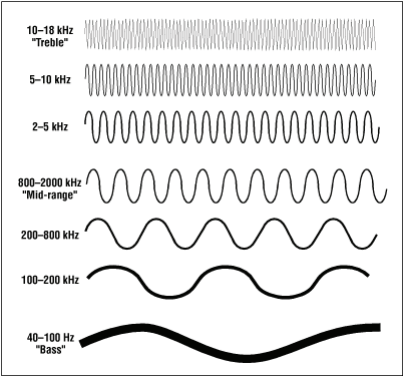
[picture p33: figure]

# SWAMP

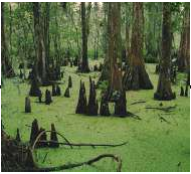
[picture p34: figure]
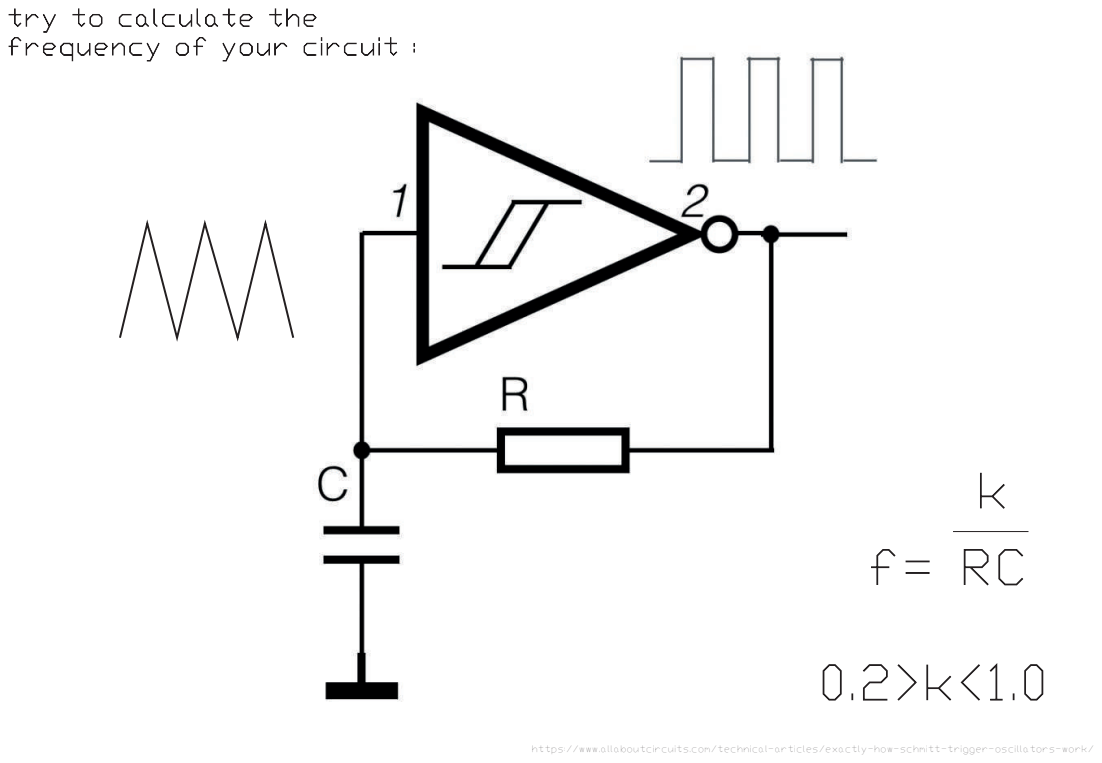
[picture p35: page 22]

https://www.allaboutcircuits.com/technical-articles/exactly-how-schmitt-trigger-oscillators-work/

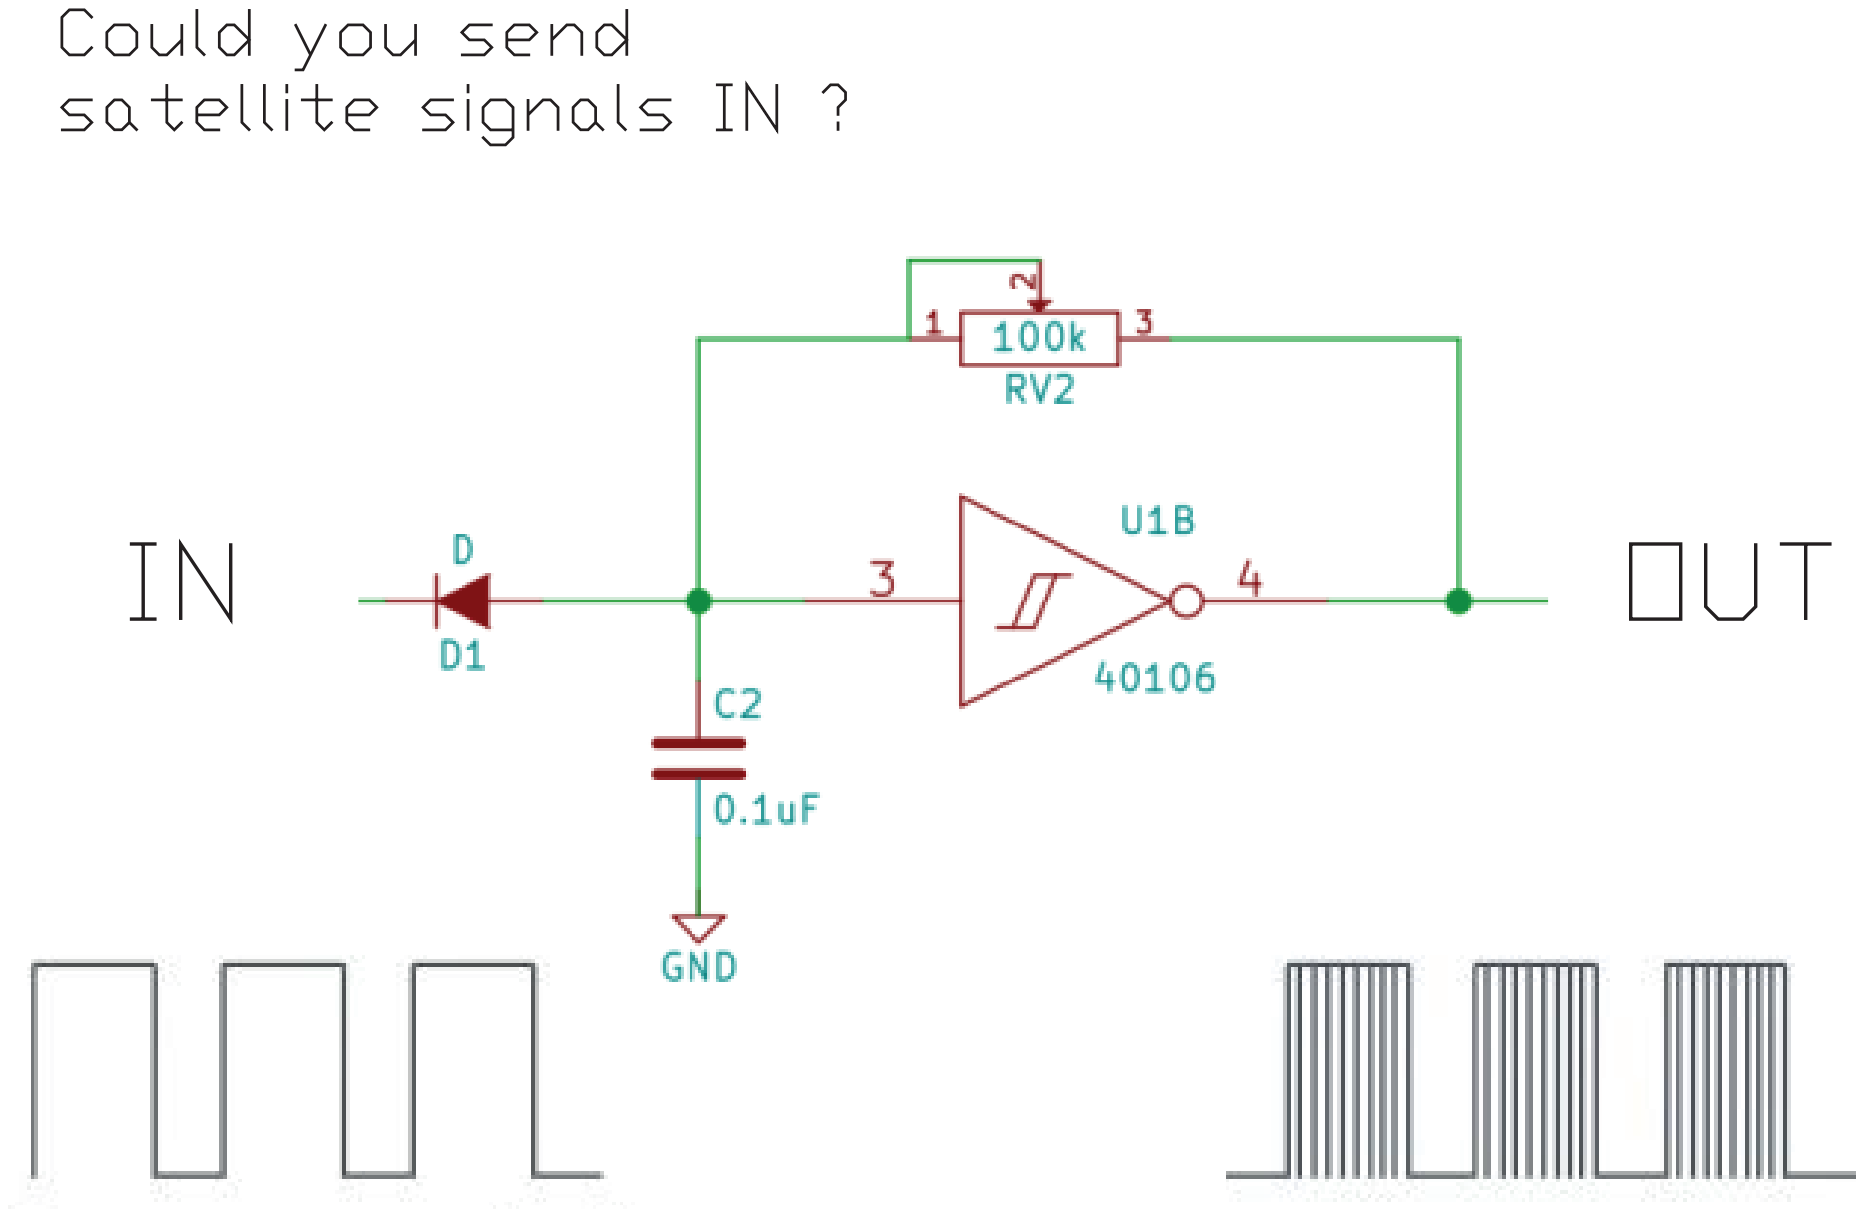
[picture p36: page 23]

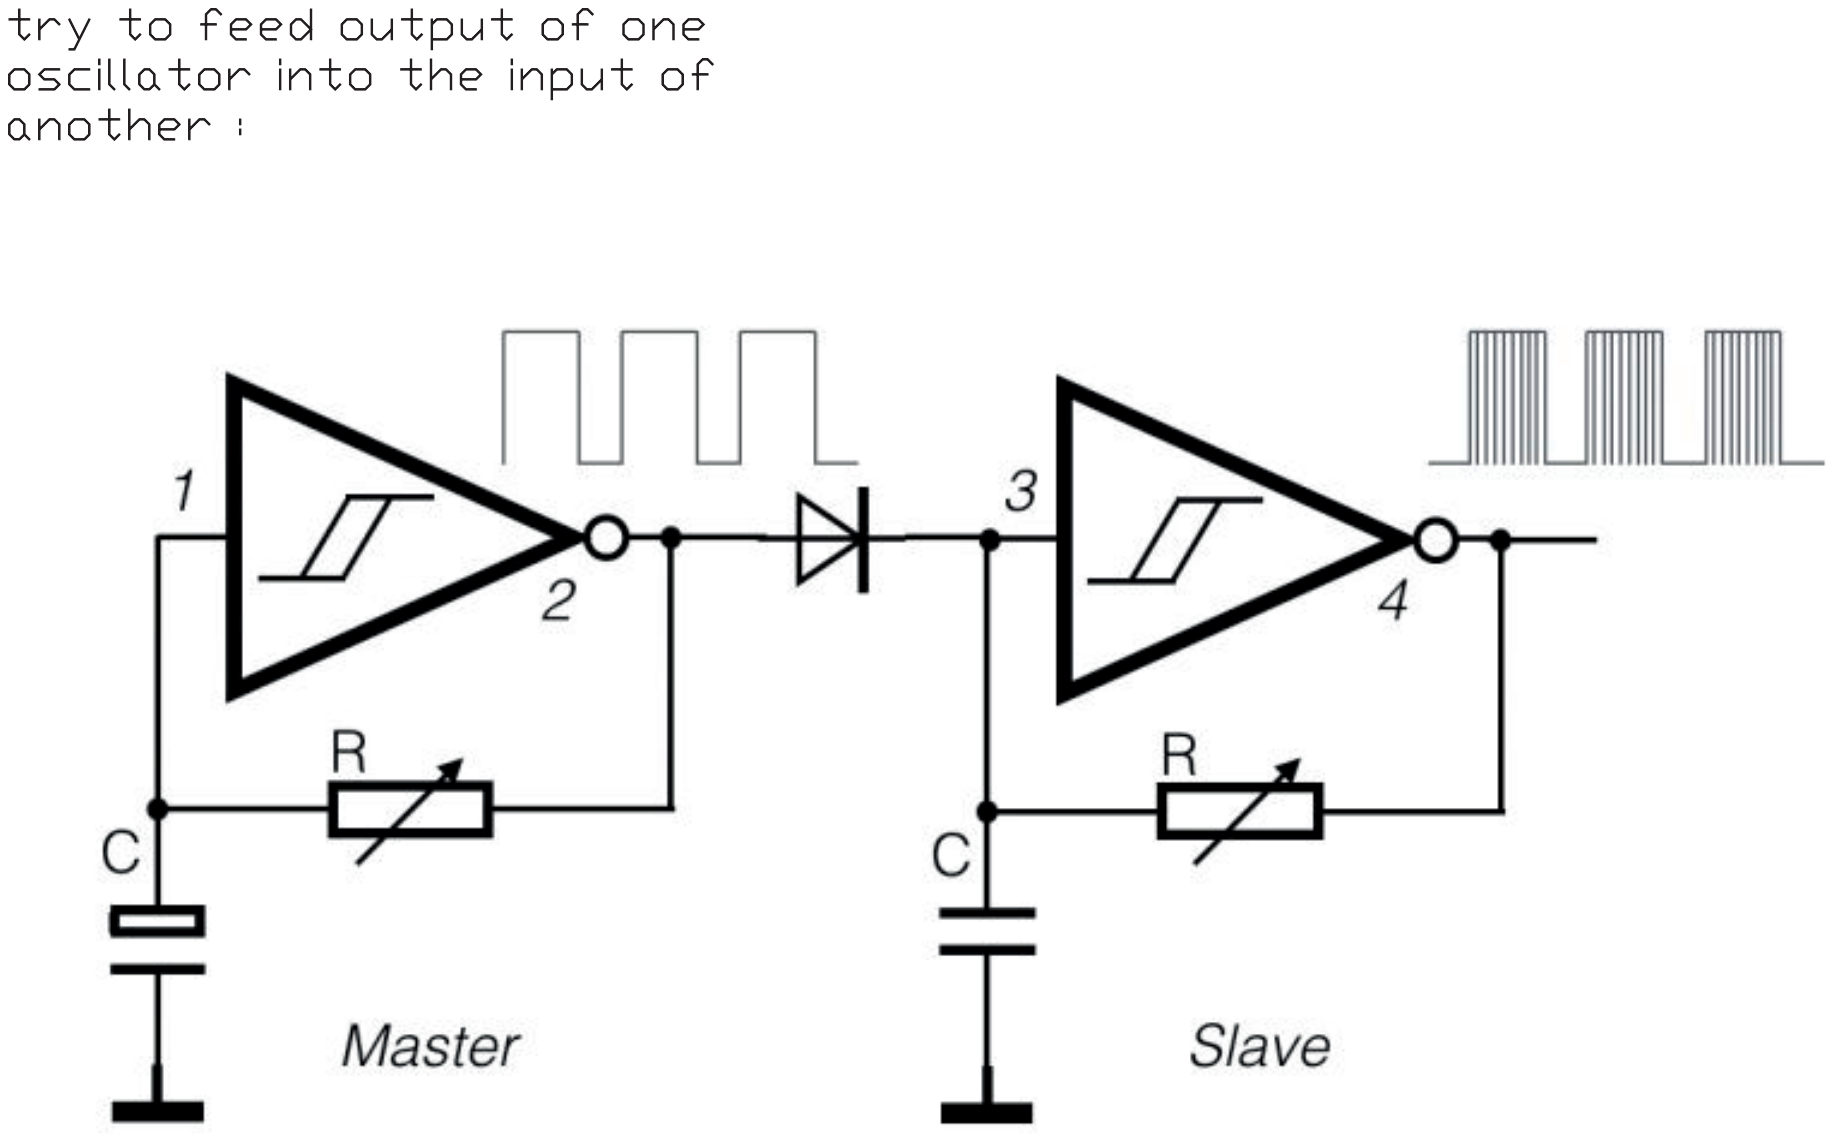
[picture p37: page 24]

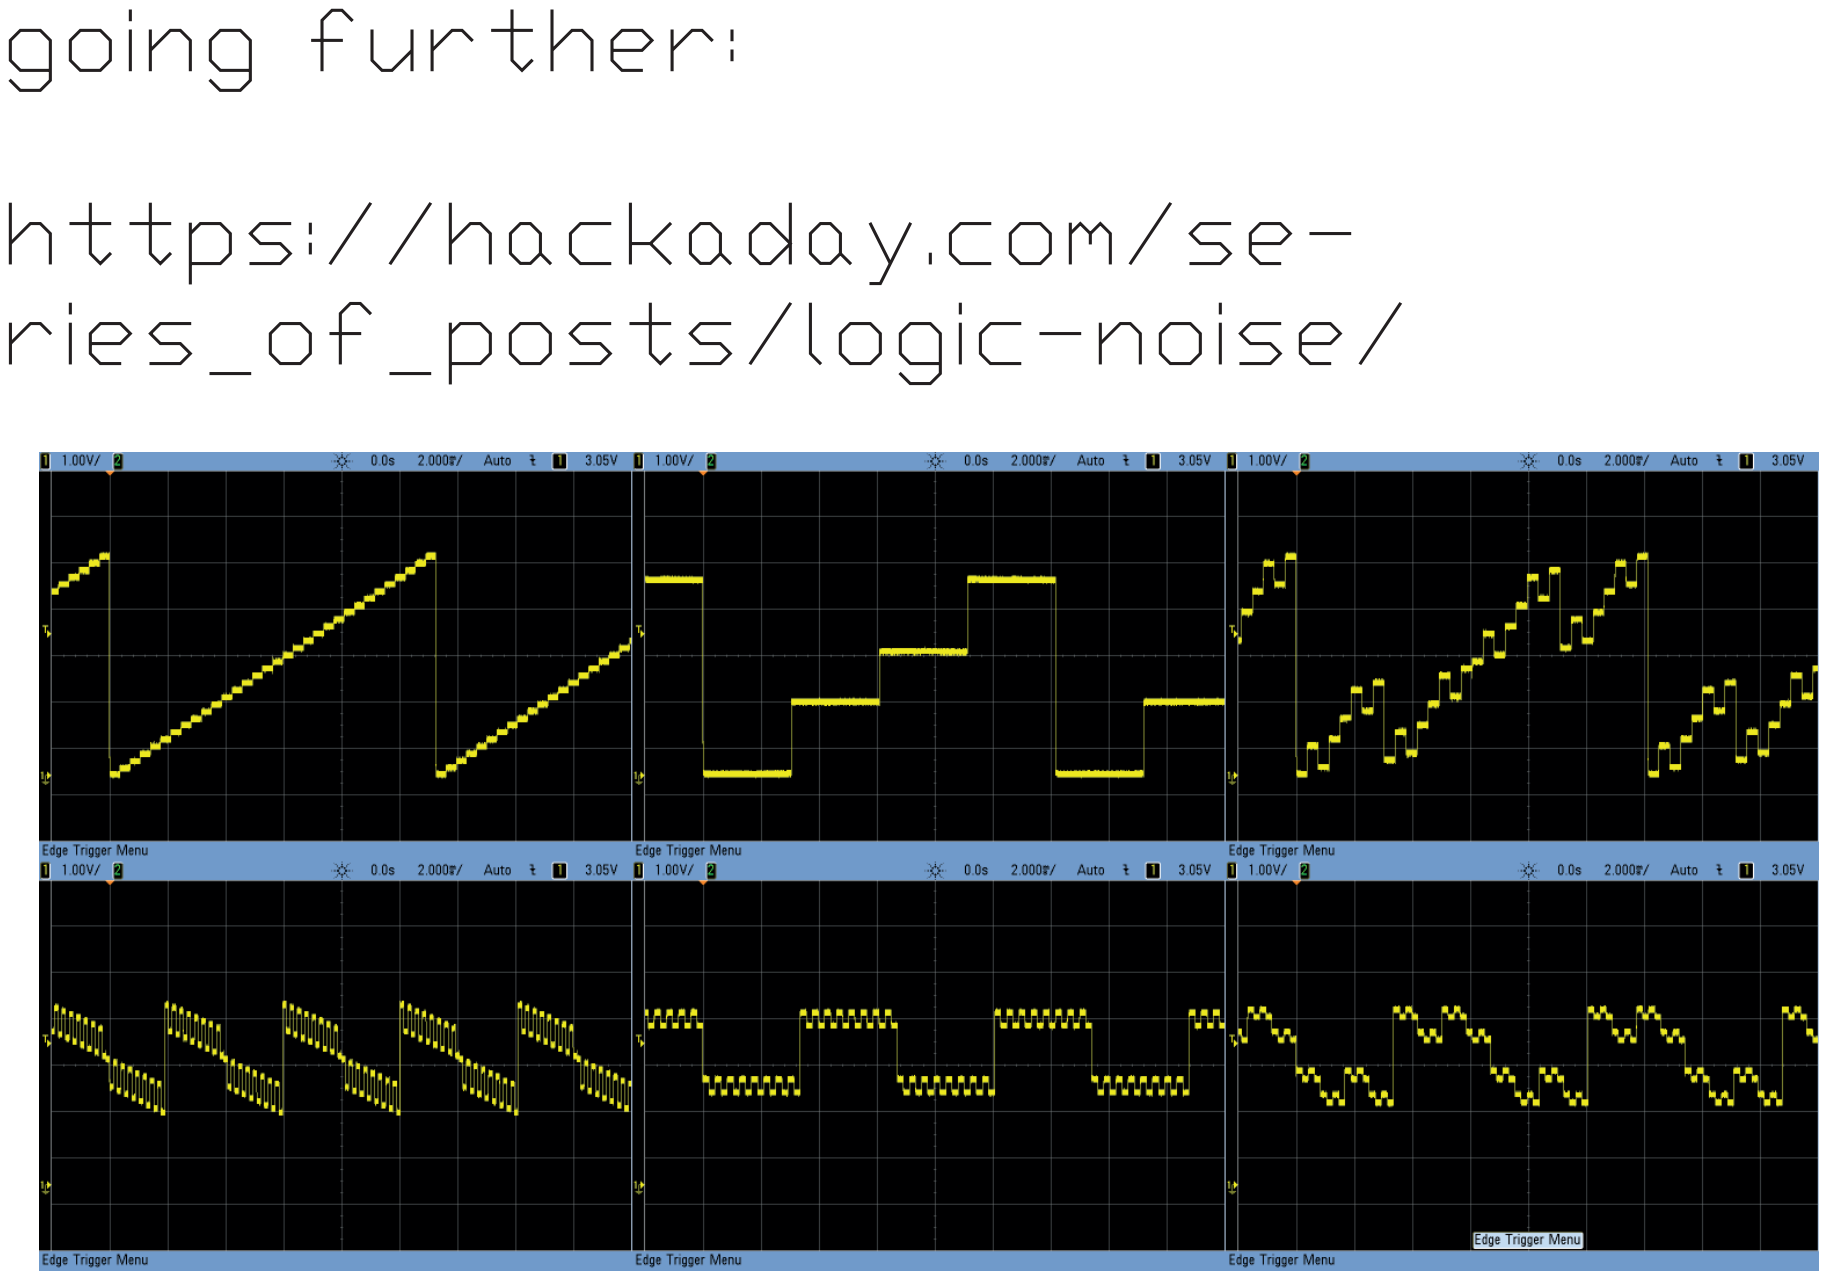
[picture p38: page 25]

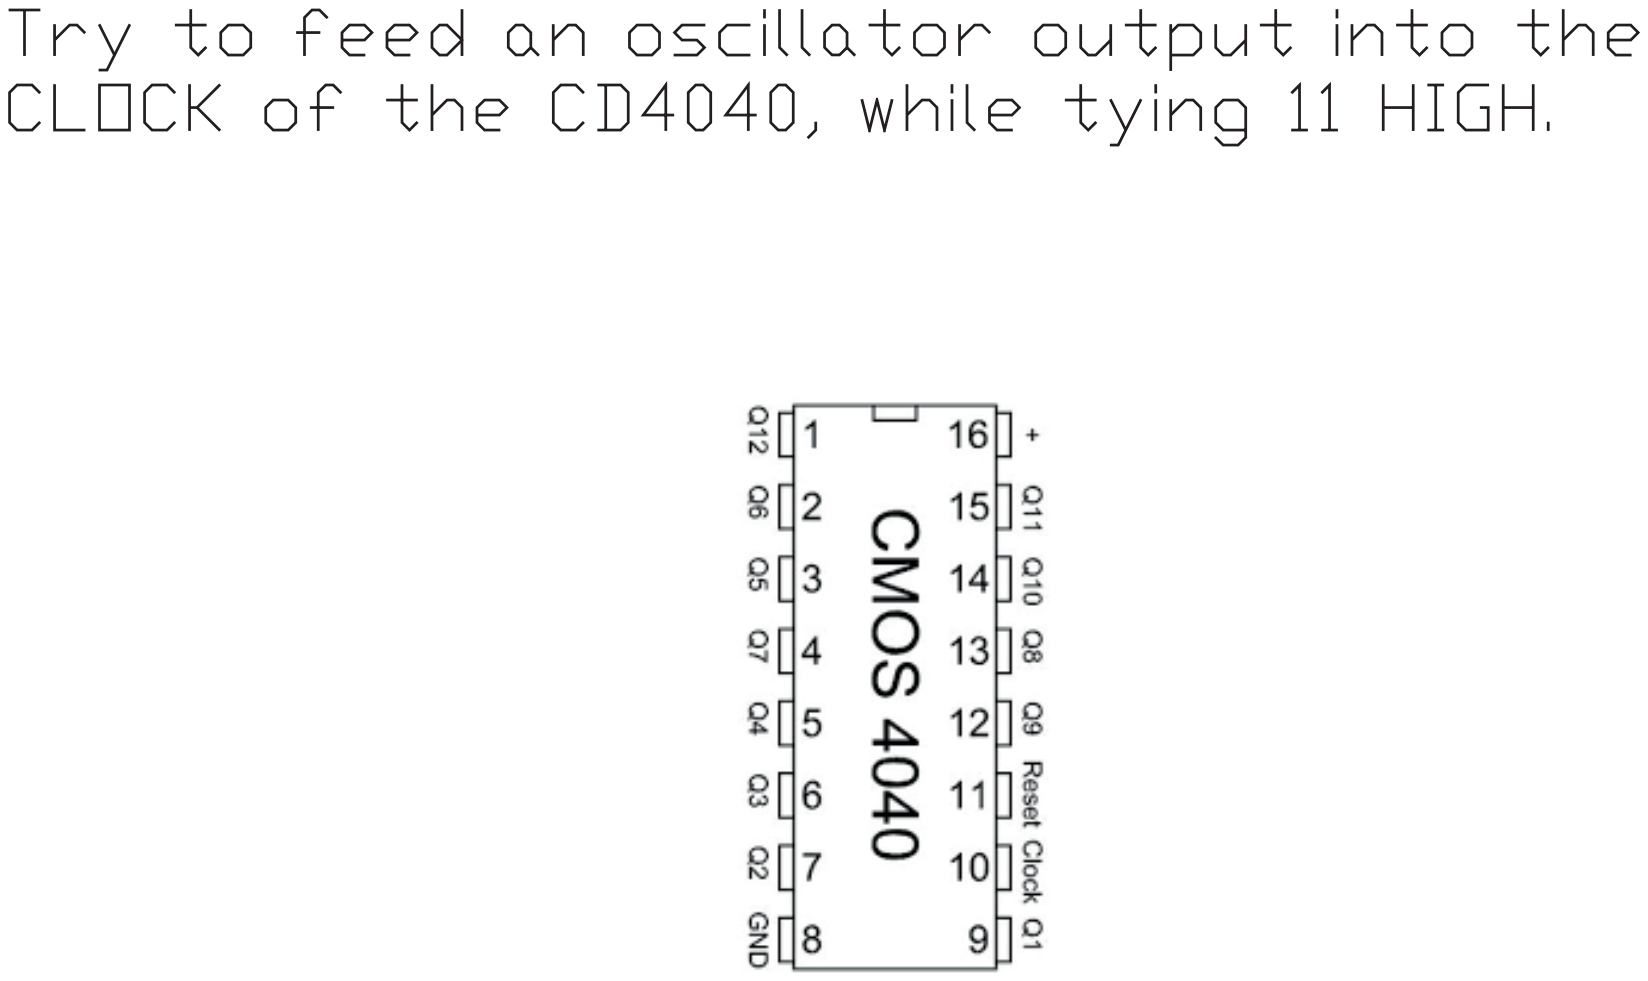
[picture p39: page 26]

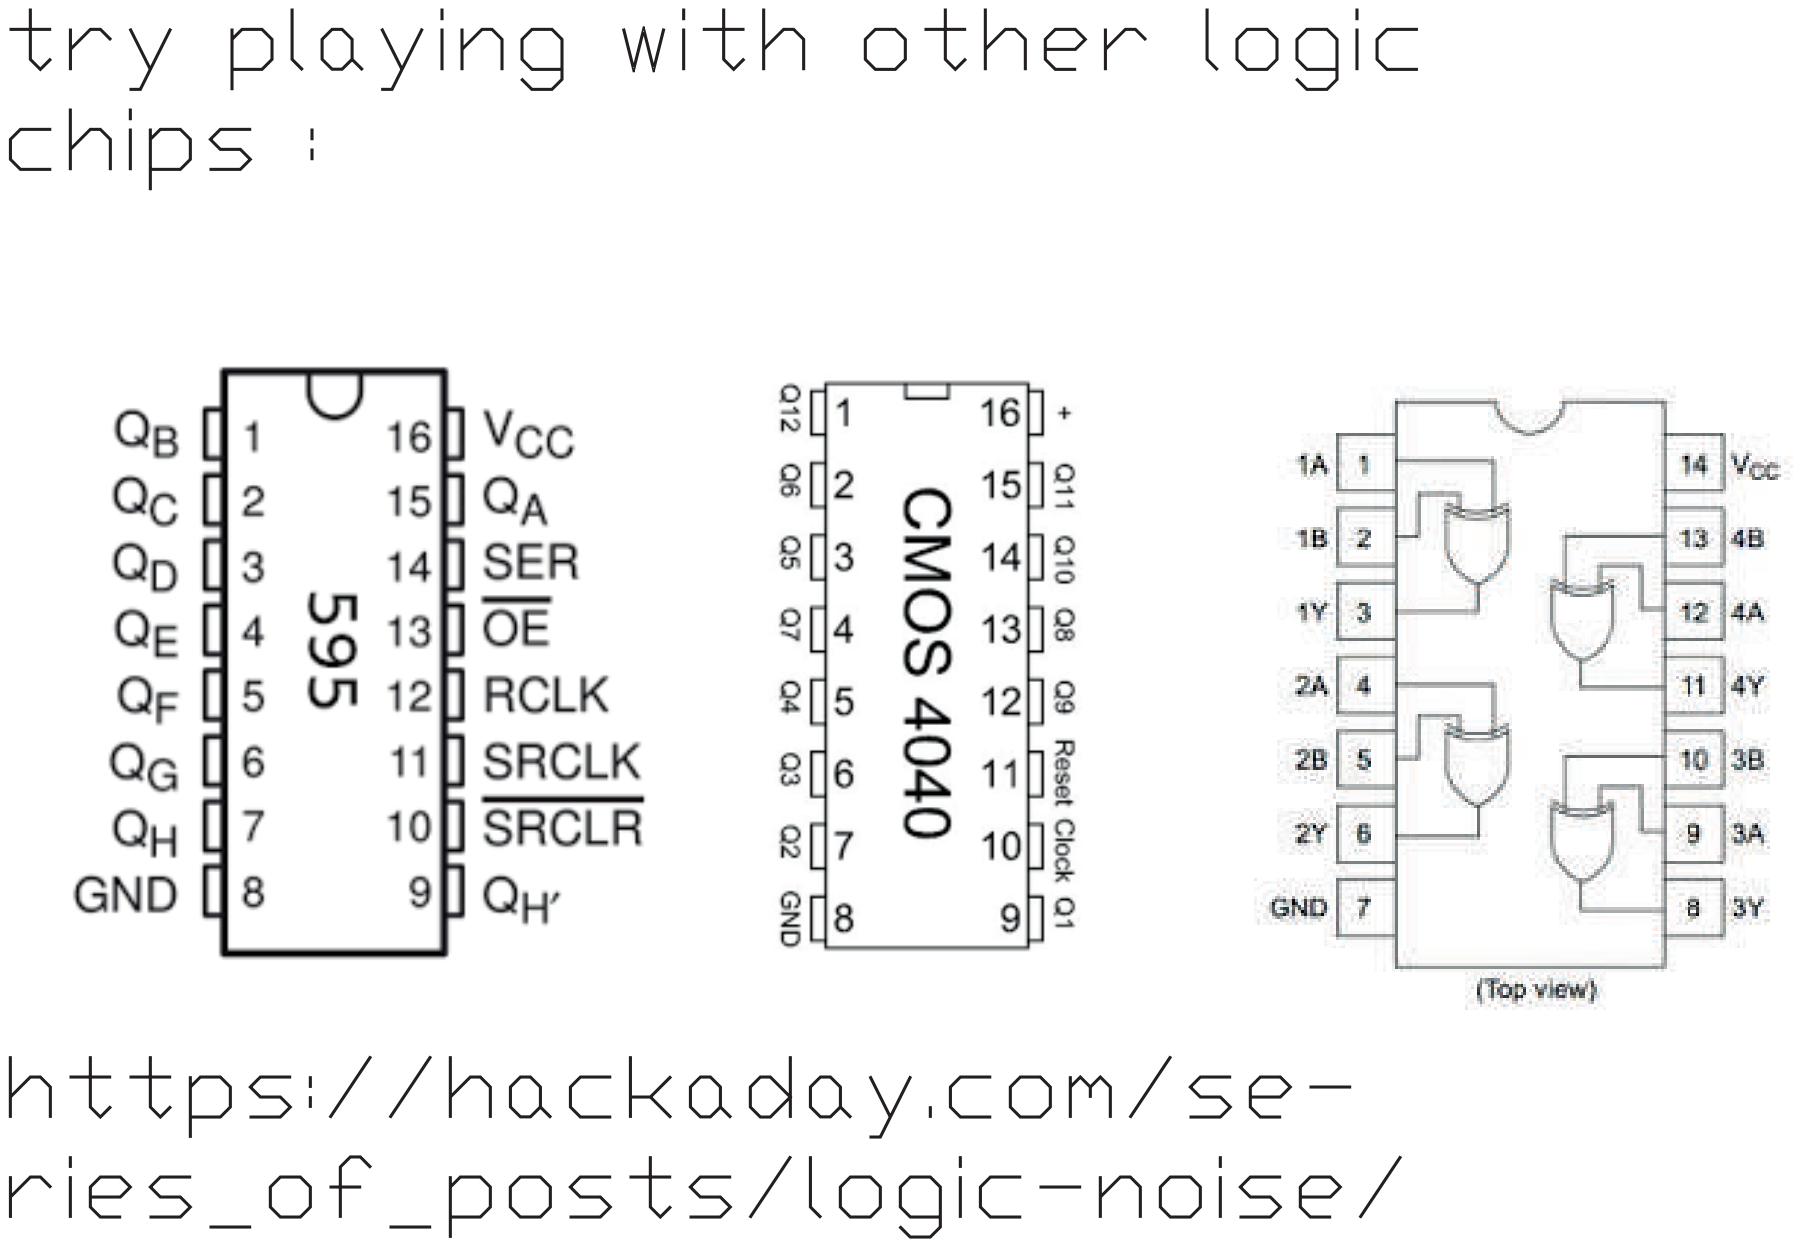
[picture p40: page 27]
