GitWorz/logic-noise-synth/kicad/circuits_son.kicad_pcb

## KiCad design kicad/circuits_son.kicad_pcb (2026-11-12)

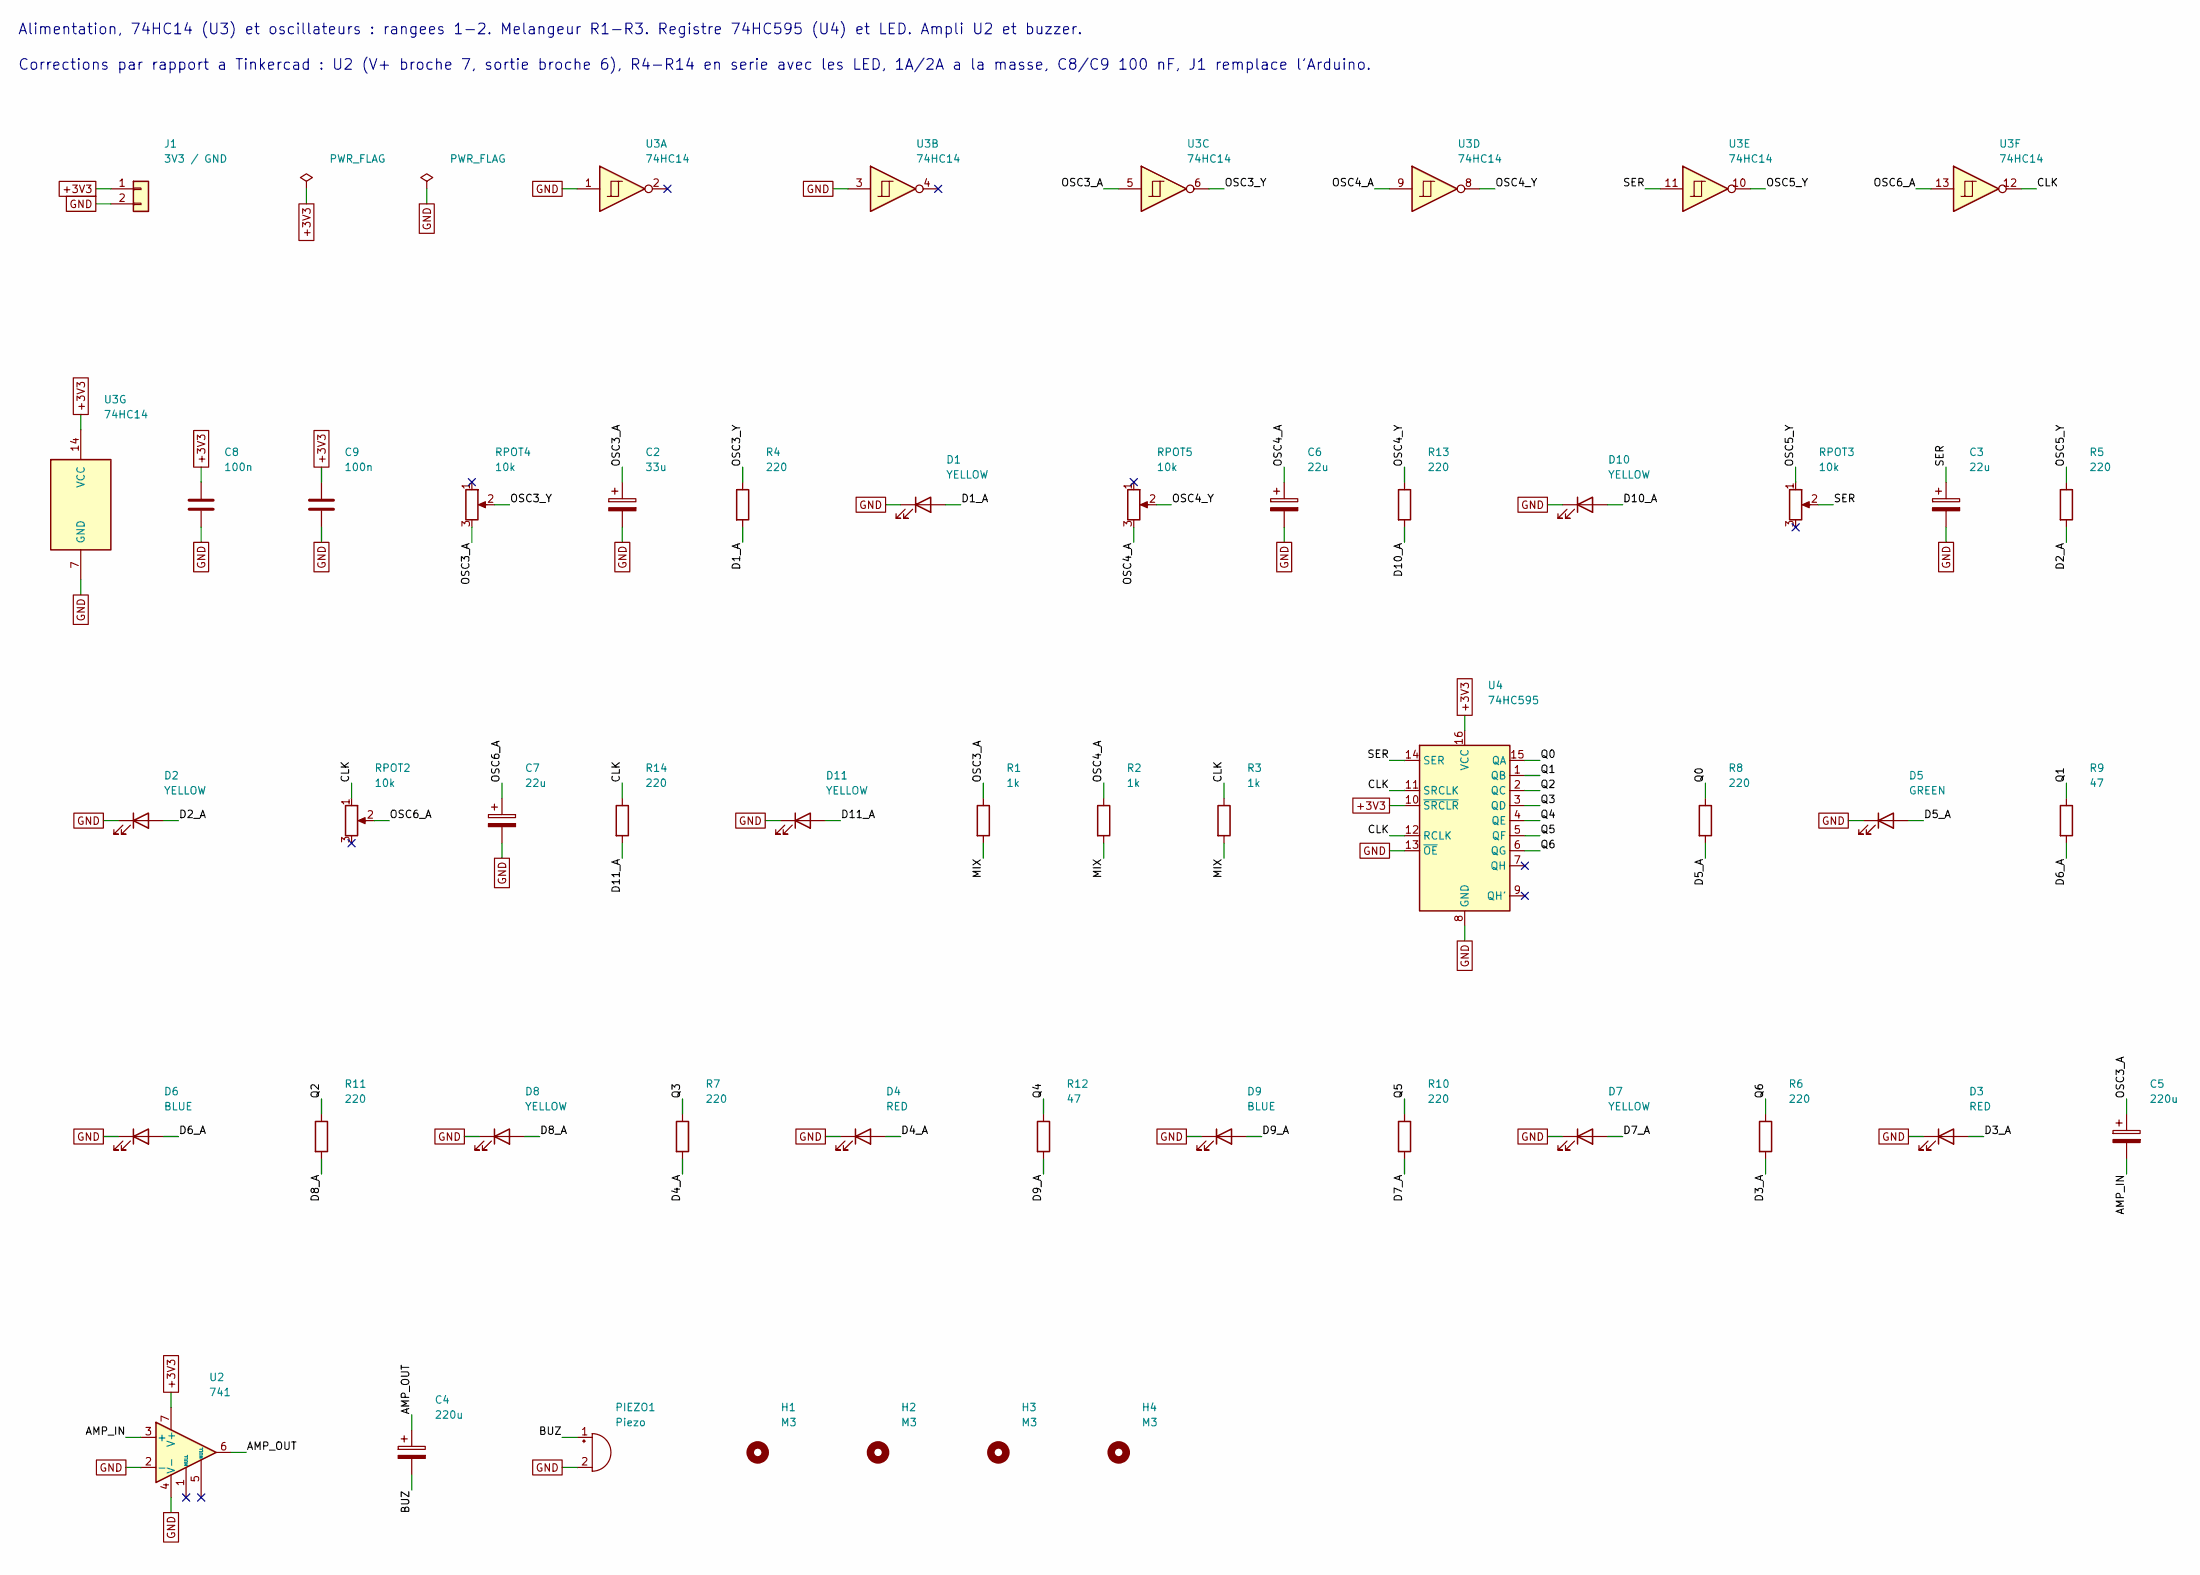
[picture p41: schematic circuits_son.kicad_sch, Circuits son]

Parts:
C2: 33u; CP_Radial_D5.0mm_P2.50mm
C3, C6, C7: 22u; CP_Radial_D5.0mm_P2.50mm
C4, C5: 220u; CP_Radial_D6.3mm_P2.50mm
C8, C9: 100n; C_Disc_D5.0mm_W2.5mm_P5.00mm
D1, D2, D7, D8, D10, D11: YELLOW; LED_D5.0mm
D3, D4: RED; LED_D5.0mm
D5: GREEN; LED_D5.0mm
D6, D9: BLUE; LED_D5.0mm
H1, H2, H3, H4: M3; MountingHole_3.2mm_M3
J1: 3V3 / GND; PinHeader_1x02_P2.54mm_Vertical
PIEZO1: Piezo; Buzzer_12x9.5RM7.6
R1, R2, R3: 1k; R_Axial_DIN0207_L6.3mm_D2.5mm_P10.16mm_Horizontal
R4, R5, R6, R7, R8, R10, R11, R13, R14: 220; R_Axial_DIN0207_L6.3mm_D2.5mm_P10.16mm_Horizontal
R9, R12: 47; R_Axial_DIN0207_L6.3mm_D2.5mm_P10.16mm_Horizontal
RPOT2, RPOT3, RPOT4, RPOT5: 10k; Potentiometre_RM-065_Vertical
U2: 741; DIP-8_W7.62mm
U3: 74HC14; DIP-14_W7.62mm
U4: 74HC595; DIP-16_W7.62mm

Connections:
+3V3: C8.1, C9.1, J1.1, U2.7 (V+), U3.14 (VCC), U4.10 (~SRCLR), U4.16 (VCC)
/AMP_IN: C5.2, U2.3 (+)
/AMP_OUT: C4.1, U2.6
/BUZ: C4.2, PIEZO1.1 (+)
/CLK: R3.1, R14.1, RPOT2.1, U3.12, U4.11 (SRCLK), U4.12 (RCLK)
/D1_A: D1.2 (A), R4.2
/D2_A: D2.2 (A), R5.2
/D3_A: D3.2 (A), R6.2
/D4_A: D4.2 (A), R7.2
/D5_A: D5.2 (A), R8.2
/D6_A: D6.2 (A), R9.2
/D7_A: D7.2 (A), R10.2
/D8_A: D8.2 (A), R11.2
/D9_A: D9.2 (A), R12.2
/D10_A: D10.2 (A), R13.2
/D11_A: D11.2 (A), R14.2
/MIX: R1.2, R2.2, R3.2
/OSC3_A: C2.1, C5.1, R1.1, RPOT4.3, U3.5
/OSC3_Y: R4.1, RPOT4.2, U3.6
/OSC4_A: C6.1, R2.1, RPOT5.3, U3.9
/OSC4_Y: R13.1, RPOT5.2, U3.8
/OSC5_Y: R5.1, RPOT3.1, U3.10
/OSC6_A: C7.1, RPOT2.2, U3.13
/Q0: R8.1, U4.15 (QA)
/Q1: R9.1, U4.1 (QB)
/Q2: R11.1, U4.2 (QC)
/Q3: R7.1, U4.3 (QD)
/Q4: R12.1, U4.4 (QE)
/Q5: R10.1, U4.5 (QF)
/Q6: R6.1, U4.6 (QG)
/SER: C3.1, RPOT3.2, U3.11, U4.14 (SER)
GND: C2.2, C3.2, C6.2, C7.2, C8.2, C9.2, D1.1 (K), D2.1 (K), D3.1 (K), D4.1 (K), D5.1 (K), D6.1 (K), D7.1 (K), D8.1 (K), D9.1 (K), D10.1 (K), D11.1 (K), J1.2, PIEZO1.2 (-), U2.2 (-), U2.4 (V-), U3.1, U3.3, U3.7 (GND), U4.8 (GND), U4.13 (~OE)

Notes on the sheet:
Alimentation, 74HC14 (U3) et oscillateurs : rangees 1-2. Melangeur R1-R3. Registre 74HC595 (U4) et LED. Ampli U2 et buzzer.
Corrections par rapport a Tinkercad : U2 (V+ broche 7, sortie broche 6), R4-R14 en serie avec les LED, 1A/2A a la masse, C8/C9 100 nF, J1 remplace l'Arduino.

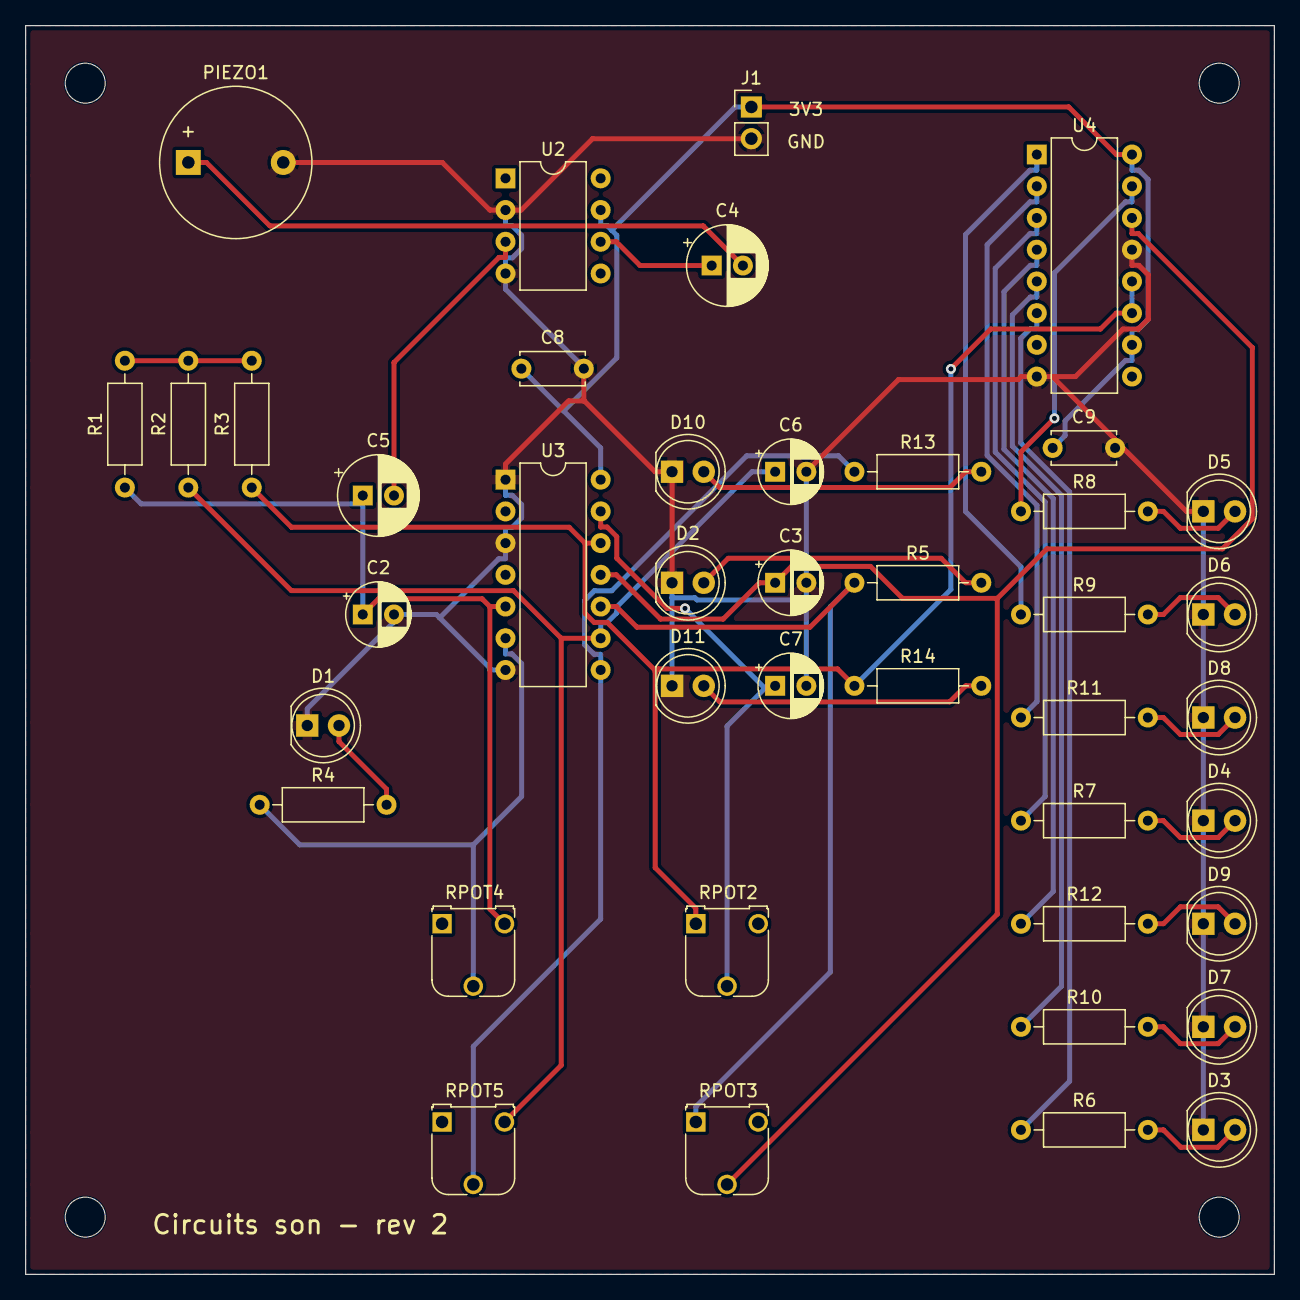
[picture p42: board circuits_son.kicad_pcb from above]

Board: 2 copper layers, 100.0 x 100.0 mm, 46 parts (0 on the bottom side), 32 nets.
