GitWorz/logic-noise-synth/(commit log)

2026-11-12 Logic Noise synth: README, media, Tinkercad, KiCad V2
    Claude-Session: https://claude.ai/code/session_01J31uq91pRttr83TUGsFWWs
    [Composants_tinkercad.csv, circuits_son.kicad_pcb, circuits_son.kicad_sch]
2026-11-12 Update KiCad V2: new PCB layout (100x100 mm, RM-065 potentiometers)
    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
    [circuits_son.kicad_pcb, circuits_son.kicad_sch]
2026-11-12 Add KiCad PCB layout and 3D view screenshots
    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
2026-11-13 Add soldered V1 photos (top, solder side, with speaker)
    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
